Isugar239/fenec-monrepo/ailogs/HARDWARE_CAN_SILKSCREEN_SWAP.md

# Постоянная заметка: шелкография CAN перепутана на этой плате

**Дата фиксации:** 2026-08-21  
**Робот:** pupper (Pupper V3)

На control board **надписи CAN1/CAN2 на шелкографии инвертированы** относительно прошивки STM и ROS/`spine_spi_test.py`.

| Шелк на PCB | В софте / прошивке | SPI leg | Ноги (передние) |
|---|---|---|---|
| CAN2 | CAN1 (`can_ch=1`) | leg0 | front left |
| CAN1 | CAN2 (`can_ch=2`) | leg1 | front right |

При отладке всегда уточнять: **шелк или софт?**

См. полный лог теста: [2026-08-21_can1_ok_can2_dead_motor_swap.md](2026-08-21_can1_ok_can2_dead_motor_swap.md)

Отдельно (2026-09-16): CAN **id моторов 1/2/3** тоже не совпадают с abad/hip/knee на железе; примеры `spine_spi_test.py` из терминала при этом едут — [2026-09-16_motor_ids_swapped.md](2026-09-16_motor_ids_swapped.md).
