Isugar239/fenec-monrepo/ОТЧЕТ.md

# Pupper v3: от исходной политики к своей системе управления

Этот документ описывает рабочую конфигурацию робота на ноябрь 2026 года. Это не рекламное описание и не инструкция «нажать одну кнопку»: робот объединяет нейросеть, ROS 2, Raspberry Pi, две STM32-платы, SPI и четыре CAN-шины. Ошибка на любом уровне может проявиться как неправильное направление сустава, отсутствие обратной связи или падение.

## Коротко

- Робот — 12-суставный квадрупед Pupper v3: по три привода на каждую ногу.
- Raspberry Pi 5 запускает ROS 2 Jazzy и вычисляет команду для политики.
- Две STM32F446 принимают пакеты по SPI и передают команды шести моторам каждая по CAN.
- В начале использовалась готовая политика и исходная модель Pupper. Затем среда и экспорт были переработаны, а текущая политика обучена отдельно владельцем проекта.
- На обе платы установлена прошивка `SPIneV1_ros_diagnostics.elf`: она сохраняет прежний размер SPI-кадра и передаёт статусы SPI/CAN в ROS.

## 1. Откуда начался проект

Первой основой был открытый стек Pupper: описание робота, MuJoCo/MJX-среда и ROS-контроллер. В истории репозитория до сих пор есть исходные политики из проекта `pupperv3-mjx-rl`; их нельзя путать с текущими весами.

Рабочая схема исходной системы осталась полезной:

1. среда симулирует корпус, суставы и контакты;
2. PPO обучает политику выдавать добавки к позе суставов;
3. экспорт сохраняет сеть, нормализацию наблюдений и параметры управления в JSON;
4. `neural_controller` выполняет JSON в цикле `ros2_control`;
5. аппаратный интерфейс переводит команды в SPI-кадры для STM.

Ссылки на первоисточники:

- [Pupper MJX](https://github.com/Nate711/pupperv3-mjx);
- [описание Pupper v3](https://github.com/g-levine/pupper_v3_description);
- [MuJoCo и MJX](https://mujoco.readthedocs.io/en/stable/mjx.html);
- [Brax](https://github.com/google/brax).

## 2. Своя модель и обучение

Исходная среда находилась в отдельном репозитории `pupperv3_mjx`; её исходники и папки прогонов не хранятся в этом монорепозитории. Поэтому здесь остаются экспорт политики, конфигурация робота и подробное описание того, как была переделана среда.

Основные изменения своей версии:

- для корпуса использованы параметры CAD, а центр масс переведён в оси `base_link`;
- сеть видит четыре кадра наблюдений, а не длинную историю исходной политики;
- один кадр содержит 36 чисел: гироскоп, гравитацию в осях корпуса, команду скорости, желаемую вертикаль, 12 позиций суставов и 12 предыдущих действий;
- вход сети имеет размер `4 × 36 = 144`;
- сеть имеет слои `256 → 128 → 128 → 128 → 12` с ELU и `tanh` на выходе;
- действие масштабируется на `0.75` рад относительно позы покоя;
- обучение использует PPO, шаг управления 20 мс и физические подшаги MuJoCo.

Текущий экспорт находится в [`policy.json`](policy.json) и в копии, загружаемой контроллером: [`ros2_ws/src/neural_controller/launch/policy_latest.json`](ros2_ws/src/neural_controller/launch/policy_latest.json). Это один и тот же файл. Его нельзя заменять старым JSON с входом 66 или 720: контроллер ожидает именно 144 значения.

Параметры, с которыми политика обучалась по командам скорости:

| Команда | Диапазон обучения |
| --- | --- |
| вперёд/назад `vx` | −0.75…0.75 м/с |
| вбок `vy` | −0.5…0.5 м/с |
| поворот `yaw` | −2…2 рад/с |

Это не паспортные максимумы робота. За пределами этих значений политика не была проверена обучением. Режим Sport на пульте намеренно превышает их и нужен только для осторожных стендовых испытаний.

Подробности постановки задачи, CAD-параметров, наград и экспорта приведены в истории этого файла. Если воспроизводимость обучения нужна третьему человеку, исходную репозиторию с `train_pupper.py`, чекпоинтами и `runs/` следует хранить вместе с этим проектом или указать её commit hash.

## 3. Что происходит на реальном роботе

Боевой запуск идёт через `robot.service`:

```text
robot.service
  └─ robot/utils/robot.sh
      └─ ros2 launch neural_controller launch.py partial_motors:=all
```

`launch.py` поднимает `ros2_control_node`, описание робота, контроллер политики, джойстик, mux команд скорости, IMU, камеру, запись bag и вспомогательные ноды. Спавнеры контроллеров запускаются только после штатного homing: в Jazzy `controller_manager` иначе может не ответить до завершения длинного поиска нулей.

Путь команды движения:

```text
DualSense / web-пульт / person follower
        ↓
      cmd_vel_mux
        ↓
  neural_controller (RTNeural)
        ↓
control_board_hardware_interface
        ↓ SPI, 6 МГц
  две STM32F446
        ↓ CAN1…CAN4
       12 приводов
```

Политика не управляет током напрямую. Она формирует целевые положения, скорости, `kp`, `kd` и feed-forward момент. Аппаратный интерфейс ограничивает команды параметрами суставов и отправляет их в контроллеры моторов.

`gain_multiplier: 2.0` в активной ROS-конфигурации удваивает `kp` и `kd` из JSON. При параметрах экспорта `kp=5`, `kd=0.25` на мотор уходит примерно `kp=10`, `kd=0.5`. Это важно при сравнении симуляции и реального поведения.

## 4. SPI, CAN и две STM

Каждая STM обслуживает две ноги. Pi отправляет по каждому CS фиксированный SPI-кадр; STM раскладывает его на три CAN-команды для каждой ноги и возвращает положения, скорости, оценки тока и флаги.

Низкоуровневые слоты протокола называются `abad`, `hip`, `knee` и соответствуют CAN ID 1, 2, 3. Это имена слотов протокола, а не доказательство физического названия сустава. Реальное соответствие суставов и CAN хранится в [`robot/config/motor_map.yaml`](robot/config/motor_map.yaml).

Карта исправляет известное скрещивание проводов первых задних моторов. Не менять знаки или CAN-карту «на глаз»: сначала нужно сделать безопасный одиночный тест с вывешенной ногой.

## 5. Диагностическая прошивка

На обеих платах установлена [`drive_spinev1/SPIneV1_ros_diagnostics.elf`](drive_spinev1/SPIneV1_ros_diagnostics.elf).

Прошивка не меняет размер SPI-пакета. Она использует существующее поле `flags[2]` для статуса:

| Бит | Значение |
| --- | --- |
| 31 | новая диагностическая прошивка отвечает |
| 0…2 | свежий ответ CAN ID 1/2/3 |
| 3 | недавняя ошибка передачи CAN |
| 4 | недавно принят корректный SPI-кадр |
| 5 | ошибка контрольной суммы SPI |
| 6 | таймаут SPI |
| 7 | включён motor mode |

ROS публикует эти данные в `/motor_bus_diagnostics` как `diagnostic_msgs/DiagnosticArray`. Проверка:

```bash
source ~/pupperv3-monorepo/ros2_ws/install/local_setup.bash
ros2 topic echo /motor_bus_diagnostics
```

Светодиод PC5 на STM показывает активную моторную команду. Свет пульта DualSense — отдельная индикация на Pi: при падении он мигает красным и пульт непрерывно вибрирует; в нормальном состоянии синий свет меняет яркость по оценке усилия. Это не измеренный ток мотора: фактический ток не передаётся из драйвера в текущем SPI-формате.

## 6. Тесты без ROS

[`tools/spine_spi_test.py`](tools/spine_spi_test.py) повторяет бинарный SPI-протокол и подходит для диагностики платы и CAN-слота. Он может включать момент, поэтому перед запуском нужно остановить основную систему:

```bash
sudo systemctl stop robot.service
cd ~/pupperv3-monorepo/tools
sudo python3 spine_spi_test.py probe
```

Полезные команды:

- `diagnostics` — статус SPI/CAN новой STM-прошивки;
- `probe` — один валидный обмен;
- `motor-probe --can N --motor abad|hip|knee` — небольшой ход одного слота;
- `motor-scan` — последовательная проверка CAN1/CAN2;
- `homing-full` — стендовая копия штатного homing, только при понятной карте моторов.

Перед любым тестом нога должна висеть свободно. После теста скрипт отправляет `flags=0` и отпускает моторы. Если процесс прерван до этого, сначала снимите питание моторов или выполните безопасное отключение момента.

## 7. Пульт и режимы скорости

Пульт обслуживается `joy_linux_node`, а dashboard отправляет feedback в `/joy/set_feedback`. Force-feedback идёт в `/dev/input/event7`, а lightbar — через драйвер `hid-playstation`.

L1 переключает три профиля:

| Режим | `vx / vy / yaw` | Индикация |
| --- | --- | --- |
| Eco | `0.75 / 0.5 / 2.0` | зелёная вспышка |
| Comfort | `1.5 / 1.0 / 3.0` | синяя вспышка |
| Sport | `3.0 / 2.0 / 6.0` | фиолетовая вспышка |

После вспышки цвет возвращается к индикации усилия. Падение имеет приоритет над режимом: красное мигание нельзя спутать со Sport.

## 8. Ограничения и следующий безопасный шаг

1. В логах ROS усилие сустава сейчас оценивается из команды PD и ошибки положения. Это полезно как индикатор, но не заменяет реальный ток.
2. Скорости Comfort и Sport выходят за диапазон обучения. Они не должны быть режимом первого запуска после ремонта.
3. Прошивка STM собрана локальным GCC 12, тогда как старый ELF собирался GCC 14. ABI и карта памяти совпадают, но проверку на стенде нельзя заменить сравнением файлов.
4. Любое изменение CAN-карты, знака оси или позиции home проверяется сначала на подвешенной ноге с малой амплитудой.

## 9. Источники

- [ROS 2 Jazzy](https://docs.ros.org/en/jazzy/) — launch, параметры и граф ROS.
- [ros2_control](https://control.ros.org/jazzy/doc/ros2_control/index.html) — hardware interface и цикл `controller_manager`.
- [STM32F446 reference manual RM0390](https://www.st.com/resource/en/reference_manual/rm0390-stm32f446xx-advanced-armbased-32bit-mcus-stmicroelectronics.pdf) — SPI, CAN и периферия микроконтроллера.
- [STM32 HAL UM1725](https://www.st.com/resource/en/user_manual/um1725-description-of-stm32f4-hal-and-low-layer-drivers-stmicroelectronics.pdf) — используемый HAL.
- [MuJoCo](https://mujoco.readthedocs.io/en/stable/) и [Brax PPO](https://arxiv.org/abs/2106.13281) — физическая среда и обучение политики.
