Isugar239/fenec-monrepo/ailogs/2026-06-26_stm_original_bno_off.md

# Лог отладки: исходная прошивка STM, отключение BNO

Дата: 2026-06-26

Продолжение: [2026-06-25_spi_loopback.md](2026-06-25_spi_loopback.md)

## Контекст
- На **обеих** STM стоит **оригинальная прошивка** (`SPIneV1` / штатная control board).
- **Перепрошить на loopback/echo нельзя** (у левой платы сломан прошивочный разъём — см. лог 2026-06-24; отладка только со штатной прошивкой + осциллограф / `spine_spi_test`).
- Ранее loopback **только на Pi** (MOSI↔MISO на малине) подтвердил, что SPI контроллер Pi исправен — см. [2026-06-25_spi_loopback.md](2026-06-25_spi_loopback.md).
- `robot.service` забивался спамом BNO055 — IMU не работает (`use_imu=false`).

## Что сделали

### 1. Убрали BNO из логов robot.service
**Источник спама:** не отдельная ROS-нода, а драйвер `BNO055` в `control_board_hardware_interface`:
- `ros2_ws/src/control_board_hardware_interface/src/rt/rt_bno055.cpp` — `printf` при ошибках I2C read
- `ros2_ws/src/control_board_hardware_interface/src/imu_manager.cpp` — фоновый поток `imu_read_thread_fn` постоянно вызывает `imu_->sample()` → `receivePacket()`

Поток крутится внутри `ros2_control_node` (плагин `ControlBoardHardwareInterface`).

**Исправление:** включён `<param name="use_imu">false</param>` в
`ros2_ws/src/pupper_v3_description/description/pupper_v3.ros2_control.xacro`.

Это не создаёт `BNO055`, не стартует IMU-поток. В логах один раз: `IMU not enabled`.
Проверено: после рестарта `robot.service` — **0 строк BNO055**.

### 2. SPI с исходной прошивкой STM (robot.service остановлен)

`spi_watch` (6 МГц, spine-пакет 132 байта):

| CE | Устройство | Наблюдение |
|----|---|---|
| CE0 | `/dev/spidev0.0` | `rv=132`, не нули; `rep_chk` прыгает (`0xffffffff`, `0x00000000`, `0x00030000`…); floats часто 0.0 |
| CE1 | `/dev/spidev0.1` | `rv=132`, `rep_chk=0xffffffff` стабильно; floats = **-nan** (MISO = 0xFF) |

`spi_loopback.py` (16 байт `0xA0..0xAF`): на обоих CE «OK», но после `xfer2` буфер перезаписан RX — видим `0x00, 0x00, 0x3f, 0xff…`, не паттерн 0xA0. Это ответ STM/шины, не чистый loopback на Pi.

В `robot.service` (до остановки): лавина `SPI ERROR BAD CHECKSUM GOT … EXPECTED 0xffffffff` — STM отвечает, но чексумма spine не сходится.

## Вывод
| Компонент | Статус |
|---|---|
| BNO055 / логи | **отключены** (`use_imu=false`) |
| SPI ioctl Pi | OK (`rv=132`) |
| CE0 + STM | есть ответ, не валидный spine |
| CE1 + STM | MISO ≈ 0xFF (-nan), slave не отдаёт данные |
| Joint states | по-прежнему не проверялись в этой сессии |

Гипотеза: обе STM на штатной прошивке, но **MISO не драйвится** (0xFF / холмики на осциллографе) — slave SPI не отвечает: NSS/CE, питание, BOOT0, обрыв MISO, или прошивка не входит в SPI handler.

## Следующие шаги
1. Осциллограф: CE0 vs CE1 — кто реально дёргается при обмене с нужной STM.
2. Проверить питание и BOOT0 обеих STM, power-cycle.
3. Сравнить `spi_watch` с документацией spine: порядок байт, размер пакета, ожидаемый `rep_chk`.
4. Когда BNO починят — вернуть `use_imu` в xacro.

## Файлы
- `tools/spine_spi_test.py` (новый)
- `ailogs/2026-06-26_stm_original_bno_off.md` (этот лог)

## 2026-06-26 (продолжение): spine_spi_test.py

Добавлен `tools/spine_spi_test.py` — Python-тест протокола spine без ROS.

Команды:
```bash
sudo systemctl stop robot.service
python3 tools/spine_spi_test.py selftest   # кодирование без железа
sudo python3 tools/spine_spi_test.py probe # разовый обмен CE0+CE1
sudo python3 tools/spine_spi_test.py watch
sudo python3 tools/spine_spi_test.py enable
sudo python3 tools/spine_spi_test.py read
sudo python3 tools/spine_spi_test.py homing --seconds 3
```

Протокол (из `rt_spi.cpp` / `rt_spi.h`):
- `spine_cmd_t`: 33×u32, XOR checksum по 32 словам, `flags[0/1]=1` включает моторы
- `spine_data_t`: 15×u32, XOR по 14 словам
- byte-swap каждого u16 на проводе, 132 байта, 6 МГц MODE0
- CE0 → ноги 0–1, CE1 → ноги 2–3

Текущий результат `probe`: обе платы `miso_0xFF` — STM не драйвит MISO (подтяжка). Homing не запускается без OK checksum.

## 2026-06-26: spi_loopback.py — ложный OK

**Баг в `spi_loopback.py`:** `spidev.xfer2` перезаписывает TX-буфер ответом. Скрипт печатал TX после xfer → оба показывали `0xFF` и «OK», хотя реально слали `0xA0..0xAF`. Исправлено: сохраняем `tx_sent` до xfer.

Правильный тест (обе STM на **оригинальной** прошивке, не echo):
```bash
sudo python3 tools/spi_loopback.py 0 0
sudo python3 tools/spi_loopback.py 0 1
```

| CE | Результат (после фикса скрипта) |
|----|---|
| CE0 | TX `0xa0..0xaf`, RX `0xFF` — spine slave не эхоит байты |
| CE1 | то же |

Ранний «OK» на CE0 — **артефакт бага**, не доказательство echo-прошивки. Echo/loopback на STM **не ставили** (перепрошить нельзя).

## 2026-06-26: осциллограф на MISO

**Наблюдение пользователя на MISO (Pi pin21 / STM PA6):**
- Нет нормальных прямоугольников 0↔3.3 В
- Только **2 небольших «холмика»**, явно **не дотягивают до 3.3 В**
- Не на всю ширину бита — активность видна **после середины** импульса SCK (или второй половины кадра)

**Интерпретация:**
| Что видим | Что это значит |
|---|---|
| MISO ≈ 3.3 В постоянно, Pi читает 0xFF | Линия **в high-Z**, тянет **подтяжка** (внутренняя Pi или внешняя), slave **не драйвит** |
| 2 маленьких холмика без полного уровня | **Не валидные биты данных** — скорее наводка от SCK/MOSI на «болтающийся» MISO, либо STM **мгновенно** пытается выставить MISO и отпускает (неправильный режим пина / slave не в SPI / NSS не совпадает) |
| Холмики «после половины» бита | Типично для **ёмкостной наводки** на floating-линии, синхронной с фронтом SCK — не для push-pull slave |

**Вывод:** аппаратно Pi→STM по SCK/MOSI/CE, вероятно, жив; **обратный канал MISO не работает как выход slave**. Это согласуется с RX=0xFF в софте.

**Что снять дальше (триггер на падение CE):**
1. **Одновременно 4 канала:** CE (pin24 или 26), SCK, MOSI, MISO — одна и та же STM (PA4–PA7)
2. **MISO на двух точках:** у PA6 на STM и у pin21 на Pi — обрыв между платами?
3. **CE0 vs CE1** при `spi_loopback.py` — какой CE доходит до какой STM (обе на orig прошивке)
4. **Замедлить SPI** до 100 кГц — если холмики те же, не timing 6 МГц
5. **BOOT0, power-cycle**, питание 3.3 V на STM — без UART echo-прошивки (перепрошить нельзя)

**Гипотезы по убыванию вероятности:**
1. STM не в режиме SPI slave (прошивка / BOOT0 / reset) — MISO не переключён в AF push-pull
2. Обрыв или плохой контакт MISO (PA6 ↔ pin21) — на STM холмики есть, на Pi нет (или наоборот)
3. NSS (PA4) не совпадает с CE — slave не выбирается, MISO остаётся в Z (холмики = наводка)
4. Повреждение вывода PA6 / линии MISO

## 2026-06-26: осциллограф CE0 + MOSI (фото)

**Снято:** CH2 зелёный = **CE0** (pin24), CH1 жёлтый = **MOSI** (pin19). Масштаб ~1 V/div.

**Что видно:**
- **CE0** — нормальный active-low: в покое ~3.3 V, на время транзакции уходит в 0 V, потом снова high.
- **MOSI** — во время (и рядом с) активным CE идут **пакеты данных** (плотная рябь 0↔high). Pi **шлёт**.
- На том же захвате: первый кусок MOSI может начинаться **чуть раньше** падения CE — стоит перепроверить **4 канала с триггером на ↓CE** (артефакт развёртки или два подряд `ioctl`).

**MISO + CE0 (отдельный замер пользователя):**
- CE0 скачки **есть** (как на фото)
- **MISO молчит** — ровная линия, slave **не выдаёт** данные

| Линия | Статус |
|---|---|
| CE0 (Pi → NSS) | ✅ Pi выбирает устройство |
| MOSI | ✅ Pi шлёт байты |
| MISO | ❌ нет ответа slave |
| SCK | не снят на этом кадре — снять следующим |

**Жёсткий вывод:** проблема **не в «Pi не шлёт»**. Цепочка **Pi → CE/MOSI/(SCK)** живая; **обратный канал MISO / STM slave** — нет. Софт `RX=0xFF` подтверждён железом.

**Следующий критичный замер:** триггер на ↓CE0, 4 канала — **CE0, SCK, MOSI, MISO** на **PA4–PA7** той STM, к которой идёт CE0:
- Падает ли **PA4 (NSS)** вместе с CE0? Если CE0 на Pi есть, а PA4 нет → обрыв CE или не та плата
- **PA6 (MISO)** — тоже молчит или есть холмики? Сравнить с pin21 Pi

## 2026-06-27: отключена вторая STM (непрошиваемая)

Пользователь **физически отключил** вторую control board (левая, без рабочего прошивочного разъёма). На шине осталась одна STM с orig-прошивкой.

**Субъективно:** «ничего не изменилось или хуже».

**Софт после отключения** (`robot.service` stop):

| Тест | Было (2 платы) | Стало (1 плата) |
|---|---|---|
| `spi_loopback` CE0 RX | `0xFF` | **`0x00`** (все нули) |
| `spi_loopback` CE1 RX | `0xFF` | **`0x00`** |
| `spine_spi_test probe` | `miso_0xFF` / -nan | **`all_zero`**, flags=0 |

**Вывод:** поведение **изменилось** — MISO перестал читаться как 0xFF, теперь **все нули**. Валидного spine-ответа по-прежнему **нет**.

**Интерпретация:**
1. **MISO, вероятно, общая** на обе платы до Pi — вторая STM тянула линию в **high** (0xFF), пока была подключена; без неё линия уходит в **0** (подтяжка вниз / только первая плата / обрыв).
2. Отключение второй платы **не починило** связь — оставшаяся STM **всё ещё не отвечает** валидными данными.
3. «Хуже» в софте: нули вместо 0xFF — joint_states остаются мёртвыми; checksum spine не сходится.

**Следующий шаг:** осциллограф на **оставшейся** плате — PA4 (NSS) при CE0, PA6 (MISO). Если NSS не падает → CE0 не доходит до этой STM. Если NSS ок, MISO молчит → прошивка/BOOT0/PA6.

## 2026-06-27: разбор `stm32_spi_slave.ino`

Просмотр тестовой прошивки (когда-то прошивали правую STM — без эффекта на MISO).

### Критический баг: PA4 (NSS) не в alternate function

Комментарий говорит «hardware NSS», но в коде:
- PA5–PA7 → **AF5** ✅
- PA4 → только `PUPDR` сброшен, **MODER остаётся GPIO input**, **AFR для PA4 не AF5** ❌

При `SSM=0` (hardware NSS) периферия SPI1 смотрит на **PA4 как SPI1_NSS**, а не на произвольный GPIO. CE с Pi на PA4 **не попадает в SPI** → slave не участвует в обмене → **MISO молчит**. Это **точно объясняет** тест с этой прошивкой.

**Исправлено в репо:** PA4 → AF5, OSPEED high; убран вечный `while (!Serial)`.

### Другие замечания

| Тема | Деталь |
|---|---|
| Не echo | `tx_buf[i]=0xA5^i` — на MISO паттерн `0xAA, 0xA5, 0xA4…`, **не** повтор MOSI. `spi_loopback` (0xA0..0xAF) **не подходит** для проверки — нужен `spi_watch` / смотреть UART `spi_count` |
| UART | `spi_count` delta > 0 при обмене с Pi = STM **видит** SPI |
| 6 МГц | ISR на байт может не успевать; для первого теста Pi на 1 МГц |
| Orig SPIneV1 | Должна конфигурировать NSS правильно (иначе не работало бы у других). Если orig тоже молчит — **железо** (PA4 не доходит от CE0, обрыв MISO) |

### Связь с осциллографом

CE0 на Pi есть, MOSI есть, MISO молчит — согласуется с **NSS не доходит до SPI** (баг прошивки **или** обрыв CE до PA4 на плате).

**Решающий замер:** PA4 на STM при ↓CE0 — если не падает, проблема **до** STM (разъём/CE mapping).

---

## Обновление: echo-прошивка для одной прошивки (2026-06-26)

UART недоступен, прошить STM можно **один раз**. Подготовлена минимальная echo-прошивка и обновлён тест.

**Подробный лог:** [2026-06-26_spi_echo_firmware.md](2026-06-26_spi_echo_firmware.md)

### Что изменено
- `tools/stm32duino_spi_slave/stm32_spi_slave.ino` — byte echo MOSI→MISO, PA4=AF5 (NSS), **без UART**
- `tools/spi_loopback.py` — 17 байт, распознаёт STM echo (`RX[0]==TX[0]`, `RX[1:]==TX[:-1]`)

### Прошивка → проверка
```bash
# Arduino/STM32Duino: upload stm32_spi_slave.ino на доступную STM
sudo systemctl stop robot.service
sudo python3 tools/spi_loopback.py 0 0 1000000   # CE0
sudo python3 tools/spi_loopback.py 0 1 1000000   # CE1
```

**Успех:** `OK — STM32 SPI echo: MOSI→MISO (pipeline 1 байт)`

### Результаты прогона (конец сессии 2026-06-26)

`robot.service` остановлен. Команды:
```bash
sudo python3 /home/pi/pupperv3-monorepo/tools/spi_loopback.py 0 0 1000000
sudo python3 /home/pi/pupperv3-monorepo/tools/spi_loopback.py 0 1 1000000
```

| CE | Устройство | TX | RX | Результат |
|----|---|----|----|---|
| CE0 | `/dev/spidev0.0` | `0xA0..0xB0` (17 байт) | все `0x00` | **FAIL** — slave молчит |
| CE1 | `/dev/spidev0.1` | `0xA0..0xB0` (17 байт) | все `0x00` | **FAIL** — slave молчит |

Вывод терминала (оба CE идентичны):
```
FAIL — 17/17 байт не совпали (ни wire, ни slave echo)
  (все нули — MISO не подключён / slave молчит)
```

**Вывод сессии:** на обоих CE MISO не отдаёт данные (нули, не echo). Echo-прошивка в репо готова, но **на плату ещё не залита** (или залита не та плата / не тот CE). Следующий шаг — одна прошивка `stm32_spi_slave.ino` на доступную STM, повторить тест на соответствующем CE.

**Пауза до следующей сессии.**
