Isugar239/fenec-monrepo/ailogs/2026-08-22_before_txrx_continuity_check_poweroff.md

# Лог: перед power-off — прозвон TX/RX CAN2 (STM ↔ MAX3051)

Дата: **2026-08-22**, ~20:30 UTC+3  
Предыдущие: [2026-08-22_after_r2_solder_still_dead.md](2026-08-22_after_r2_solder_still_dead.md), [2026-08-22_before_r2_solder_poweroff.md](2026-08-22_before_r2_solder_poweroff.md)

---

## Итоговая картина (зафиксировано пользователем)

| | CAN1 / leg0 (шелk CAN2, левая) | CAN2 / leg1 (шелk CAN1, правая) |
|---|---|---|
| **fb в софте** | ✅ меняется | ❌ всегда 0 |
| **Нога двигается** | ✅ да | ❌ нет |
| **Красный LED на моторах** | горит постоянно | горит постоянно (только питание!) |
| **Swap DAP** | — | мёртвость не переехала |
| **R2 120 Ω** | — | запаян — не помог |
| **Напряжения DD4** | — | OK (пользователь проверила) |

**Вывод:** CAN2 мёртв **целиком** (не только RX). Команды с STM, похоже, **не доходят** до шины → подозрение на **TX/RX между STM и MAX3051 (DD4)** или мёртвый DD4.

⚠️ Шелк CAN1/CAN2 на spine **перепутан** — см. [HARDWARE_CAN_SILKSCREEN_SWAP.md](HARDWARE_CAN_SILKSCREEN_SWAP.md).

---

## Последний probe (2026-08-22 вечер)

```
[/dev/spidev0.0] CE0 board0 legs[0,1]: checksum_OK
    leg0: abad= 0.1223 hip= 0.2565 knee= 0.1211  ✅
    leg1: abad= 0.0000 hip= 0.0000 knee= 0.0000  ❌
```

## Последний wiggle с feedback

**CAN1 (левая):**
- abad: fb застрял ~0.122 (робот лежит — abad мог упираться)
- hip: span=0.633 OK
- knee: span=0.249 OK

**CAN2 (правая):**
- abad/hip/knee: cmd меняется, **fb=0.000**, span=0.000

---

## Что проверить ПОСЛЕ power-off (мультиметр, прозвонка)

**Питание полностью выключено.** Режим **Ω / diode / continuity** (писк).

### Spine STM (прошивка `drive_spinev1`)

| Сигнал | Pin STM | Pin MAX3051 (DD4) | Живой канал для сравнения |
|---|---|---|---|
| CAN2 TX | **PB13** | pin **1** (TX) | PB9 → DD2 pin 1 |
| CAN2 RX | **PB12** | pin **4** (RX) | PB8 → DD2 pin 4 |

### E3.pdf (если CAN2 идёт через distribution-плату, DD4)

| Сигнал | Pin STM (DD1) | Pin MAX3051 (DD4) |
|---|---|---|
| CAN2 TX | **PA12** | pin **1** |
| CAN2 RX | **PA11** | pin **4** |

**Ожидание:** **~0 Ω** (короткий писк) на каждой паре.

| Результат | Значит |
|---|---|
| **Пищит** на TX и RX | Дорожки целые → подозреваем **сам DD4** или CANH/L после чипа |
| **∞ на TX (PB13→DD4-1)** | **Обрыв TX** — главный подозреваемый |
| **∞ на RX** | Обрыв RX |
| **∞ на обоих** | Обрыв/не та плата/не те pin'ы |

### Дополнительно (опционально)

| Замер | Ожидание |
|---|---|
| DD4 pin 3 (VCC) ↔ GND | **не 0 Ω** (не КЗ) |
| CANH (pin 7) ↔ CANL (pin 6) через R2 | **~120 Ω** |
| CANH/L на разъёме ↔ pin 7/6 DD4 | **~0 Ω** каждая |

---

## Команды после включения

```bash
cd ~/pupperv3-monorepo/tools
sudo systemctl stop robot.service
sudo python3 spine_spi_test.py probe -v
sudo python3 spine_spi_test.py wiggle-can2-all --seconds 2 --amplitude 0.10 --hz 0.4
```

---

## Состояние системы

- `robot.service`: **inactive**
- Пользователь выключает питание для **прозвонки TX/RX**
- CE1 (`spidev0.1`) по-прежнему `all_zero` — отдельная проблема (вторая STM)
