Isugar239/fenec-monrepo/ailogs/2026-08-23_before_tx_jumper_poweroff.md

# Лог: перед power-off — jumper TX PB13 → DD4 pin 1

Дата: **2026-08-23**  
Предыдущий: [2026-08-23_after_tx_resolder_2_still_fail.md](2026-08-23_after_tx_resolder_2_still_fail.md)

---

## Текущая картина

| | CAN1 leg0 (левая) | CAN2 leg1 (правая) |
|---|---|---|
| probe | ✅ | ✅ (RX жив) |
| wiggle fb | ✅ движение | ❌ span≈0, fb застрял |
| физически | двигается | **не двигается** |
| звук | жжж + движение | **короткий жжж**, без движения |

**Вывод:** TX CAN2 работает **кусками** (enable → звук), нормальное управление нет.  
Прозвонка PB13↔DD4-pin1 **звонится**, но под нагрузкой может рваться → подозрение на **дорожку TX**.

Перепайка TX ×2 — **не помогла**. R2 120Ω — стоит. Swap DAP — не помог.

---

## Что делает пользователь сейчас

**Power OFF** → jumper (восковка/провод):

```
PB13 (STM TX CAN2) ──── провод ──── pin 1 (TX) DD4 MAX3051
```

- **Не** CANH/CANL
- **DD4**, не DD2 (CAN1)
- Короткий провод, не параллельно CAN-линиям

---

## После включения — тест

**Не двигать правую ногу руками!**

```bash
cd ~/pupperv3-monorepo/tools
sudo systemctl stop robot.service
sudo python3 spine_spi_test.py probe -v
sudo python3 spine_spi_test.py wiggle-can2-all --seconds 3 --amplitude 0.12 --hz 0.4
```

## Интерпретация

| Результат | Вывод |
|---|---|
| fb меняется, нога **сама** двигается | ✅ **дорожка TX бита** — jumper оставить |
| жжж, fb=0, нет движения (как сейчас) | jumper не помог → **менять DD4** |
| leg1=0 в probe | не туда припаяла / новая проблема |

---

## Состояние

- `robot.service`: **inactive**
- CE1 spidev0.1: `all_zero` (вторая STM, отдельно)
- SSH отвалится при power-off — нормально
