Isugar239/fenec-monrepo/ailogs/2026-08-31_homing_full_front.md

# Лог: homing-full передние ноги

Дата: **2026-08-31**  
Сырьё: `raw/2026-08-31/homing_full_board0_retry2.txt`

Задние (CE1) молчат — **не все 12**, только CAN1+CAN2.

Первый запуск оборвался: homing слал полный пакет, потом `enable_only` на чтение → SPI BAD_CHK/all_zero и ложные Homed с мусором (`1e19`).

Повтор: состояние берётся из того же командного кадра.

```
Homed knees → hips → abads, Finished 1.7s / 84 шагов
до:  L -0.514 / 0.257 / 3.847    R  0.592 / -0.022 / -3.893
после: L -0.513 / 0.619 / 3.869    R  0.564 / -0.305 / -3.937
```

Хипы реально уехали (~0.3 рад). Колени почти нет (уже ±3.85, «упор» ложный). 1.7 с — не настоящий механический homing.

**Пользователь подтвердила:** обе передние ноги **отодвинулись от тела** (хипы). Значит TX на CAN1 и CAN2 доходит до hip-моторов.

`robot.service` оставлен **inactive**.
