Isugar239/fenec-monrepo/ailogs/2026-08-31_legs_powered_wiggle.md

# Лог: питание лап включили — probe OK, wiggle без движения

Дата: **2026-08-31**  
Предыдущий сегодня: [2026-08-31_legs_spi_all_zero.md](2026-08-31_legs_spi_all_zero.md)  
23-е: [2026-08-23_before_dd4_replace_poweroff.md](2026-08-23_before_dd4_replace_poweroff.md)  
Сырьё: `ailogs/raw/2026-08-31/spi_probe_powered.txt`, `wiggle_can1_powered.txt`, `wiggle_can2_powered.txt`

---

## Probe (питание есть)

```
CE0 checksum_OK
  leg0 CAN1: abad=0.076 hip=0.250 knee=0.291  ✅
  leg1 CAN2: abad=-0.020 hip=0.076 knee=-0.309  ✅ RX жив
CE1 all_zero (вторая STM, как раньше)
```

I2C-1 по-прежнему пустой (нет `0x48`). EXT5V ~5.14 V в момент probe.

---

## Wiggle (скрипт пишет OK — это ложные span)

`fb` в логе — **сырой** угол STM, `cmd` — после `SIDE_SIGN`. Поэтому cmd ≈ −fb в покое. Реальное движение = **меняется ли fb**.

### CAN2 правая (шелк CAN1)

| Сустав | fb во время теста | Реально |
|---|---|---|
| abad | застрял −0.020 | ❌ |
| hip | застрял +0.073 (первый кадр BAD_CHK, мусорный span) | ❌ |
| knee | −0.327 … −0.302 (Δ≈0.025) | ❌ почти нет |

cmd ходит ±0.12, fb не следует. Как 23-го.

### CAN1 левая (шелк CAN2)

| Сустав | fb во время теста | Реально |
|---|---|---|
| abad | застрял +0.076 (span=0.152 = 2×\|q\|, знак) | ❌ |
| hip | застрял +0.250 | ❌ |
| knee | +0.286 … +0.298 (Δ≈0.012) | ❌ |

**23-го CAN1 физически ехал.** Сегодня не едет тоже.

После wiggle углы те же ±шум.

---

## Вывод

Логика STM/CAN **RX жива на обеих передних**. TX/момент на моторы **не доходит** (или нет силового питания моторов / ноги упёрты).

CAN2 — тот же диагноз, что 23-го (jumper TX / DD4).  
CAN1 сегодня ведёт себя так же — либо силовая шина моторов ещё не под напряжением, либо ноги зажаты.

`robot.service` снова **active**.
