Isugar239/fenec-monrepo/ailogs/2026-09-23_joints_ok_stand_bno.md

# Лог: суставы едут, стойка кривая, БНО в софте выключена

Дата: **2026-09-23** (~20:45 MSK)  
Хост: `pupper` (`pi@10.2.0.217`)  
Предыдущие: [2026-09-16_motor_ids_swapped.md](2026-09-16_motor_ids_swapped.md), [2026-06-26_stm_original_bno_off.md](2026-06-26_stm_original_bno_off.md)

## Главное

Суставы на этом запуске **завелись**. Походку включали (`neural_controller` activate). **Нормально не стоит.** Подозрение — нет рабочей связи с БНО.

В этом же старте софт сам пишет `IMU not enabled`: в `pupper_v3.ros2_control.xacro` параметр `use_imu` стоит `false`. Драйвер BNO055 не читается, в политику уходит единичный кватернион («стою ровно»), даже если корпус наклонён. Угол платы в `components.xacro` при этом не применяется.

Плата БНО переставлена вертикально, «90° вверх». В `components.xacro` pitch сменён с `-2.35619` (−135°) на `-1.57079632679` (−90°). Пока `use_imu=false`, эта правка на стойку не влияет.

Hailo для походки не нужен: нода падает без драйвера, сервис от этого не останавливается.

## Хоуминг 20:41:12

Почти все суставы `ЕХАЛ ДЕРЖИТ`. Исключения по таблице:

| Сустав | CAN | id | Δ | Статус |
|---|-----|----|---|---|
| leg_front_r_2 | 2 | 2 | −0.097 | СТОИТ ДЕРЖИТ |
| leg_back_l_2 | 3 | 2 | +0.037 | СТОИТ ДЕРЖИТ |
| leg_back_r_2 | 4 | 2 | −4.130 | ЕХАЛ ДЕРЖИТ (большой ход) |

Остальные восемь проехали и держат момент. Заднее правое колено в этом запуске тоже поехало (в 20:40 оно было `СТОИТ ОТПУЩЕН`).

## Походка

- 20:42:49 `neural_controller`: activate successful
- 20:43:41 deactivate
- 20:43:54 activate снова
- 20:45:04 deactivate

На глаз стойка не нормальная. Команда скорости не слалась: контроллер сам тянет суставы в `default_joint_pos` и дальше крутит политику.

## Что не проверено

Живой ли I2C BNO055 на проводе, в этом логе не меряли. Сначала в конфиге `use_imu=false`, поэтому «нет связи» здесь — это выключенный драйвер, не обязательно мёртвый чип.
