Isugar239/fenec-monrepo/ailogs/2026-08-31_legs_retry2_can2_knee.md

# Лог: повторный wiggle — CAN2 knee едет, CAN1 fb застыл

Дата: **2026-08-31** (вторая попытка, питание было)  
Предыдущий: [2026-08-31_legs_powered_wiggle.md](2026-08-31_legs_powered_wiggle.md)  
Сырьё: `raw/2026-08-31/wiggle_can1_retry2.txt`, `wiggle_can2_retry2.txt`

Между попытками `robot.service` крутился — углы уехали (похоже homing/unwrap):

```
до:  CAN1 0.076 / 0.250 / 0.291     CAN2 -0.020 / 0.076 / -0.309
после: CAN1 -0.506 / 0.274 / 3.854  CAN2  0.597 / -0.024 / -3.895
```

---

## CAN1 левая — fb не сдвинулся

Пользователь в **прошлом** прогоне слышала звук и дёрганье. В этом fb константа:

| Сустав | fb |
|---|-----|
| abad | −0.506 весь прогон |
| hip | +0.274 |
| knee | +3.854 |

«span OK» в скрипте = 2×\|q\| (знак cmd vs raw), не движение.

## CAN2 правая — **knee едет**

| Сустав | fb | |
|---|-----|---|
| abad | застрял +0.597 | ❌ |
| hip | застрял −0.024 | ❌ |
| knee | −3.939 … −3.767 (Δ=0.172, следует cmd) | ✅ первое реальное движение CAN2 с 23-го |

---

## Вывод

TX на CAN2 **не мёртвый**: колено правой ноги отслеживает команду. Abad/hip CAN2 и все три CAN1 в этом прогоне по энкодеру молчали (CAN1 физически дёргалась в прошлом).

Jumper TX, скорее всего, жив. DD4 целиком не «труп». Дальше: abad/hip CAN2 (другой мотор/разъём/ID) и почему CAN1 нестабилен.
