Isugar239/fenec-monrepo/ai/rl/REAL_DATA.md

# Реальные данные Pupper: как записать и как на них учиться

Инструкция для человека или ИИ, который продолжит работу. Код записи — `tools/pupper_record.py`, кнопка «Запись» в пульте (`tools/pupper_dashboard`).

## Главное решение: чему учиться на реальных данных

Политику ходьбы учим в симуляции (MJX, `pupper_mjx_rl_training.py`, 1B шагов на GPU). Реальные данные нужны, чтобы **симулятор стал похож на робота** (system identification, sysid), а не чтобы учить политику прямо на них. Причины:

- Политика плохо ходит на железе почти всегда из-за разрыва sim→real: другие kp/kd, трение и инерция ротора, задержка, масса и центр масс, нули суставов. Сотни тысяч эпизодов на реальном роботе не собрать, а 10–20 минут записи хватает, чтобы подогнать 5–15 параметров симулятора.
- Обучение прямо на роботе (онлайн RL в реальном времени, SAC/DroQ, как в работах «learning to walk in the real world») возможно: порядка десятков минут до часа хождения с ручными подъёмами после падений. Нужны ПК с GPU рядом, сеть с малой задержкой, автоматический подъём или человек и крепкая механика. Этот путь стоит пробовать только после того, как sim→real с подогнанным симулятором не помог.
- Behavior cloning с генератора траекторий бессмыслен: генератор и так известен как формула (`tools/open_loop_gait.py`).

Порядок работы: **(1) sysid приводов на подставке → (2) sysid корпуса на полу → (3) переобучение с новыми параметрами и сужением рандомизации → (4) проверка политики на роботе с записью → сравнение наблюдений sim и real.**

## Что пишется

`python3 tools/pupper_record.py record --note "..."` или кнопка в пульте создаёт каталог `~/pupper_data/<время>_<метка>/`:

- `bag/` — `ros2 bag` в формате mcap, без прореживания:
  - `/joint_states` около 256 Гц: позиция, скорость, effort (оценка момента с драйвера, Н·м);
  - `/imu_sensor_broadcaster/imu` около 256 Гц;
  - `/forward_position_controller|kp|kd/commands` — команды генератора, стойки и пульта (12 чисел, порядок как в `JOINTS`);
  - `/neural_controller/position_command` и `/neural_controller/observation` — команды и наблюдения политики;
  - `/cmd_vel`, `/emergency_stop`, `/robot_description` (URDF с нулями хоуминга на момент записи).
- `meta.json` — заметка, git-коммит и список изменённых файлов, `motor_map.yaml`, параметры режима от пульта (`extra`: параметры генератора `tg_params`, режим).

Объём — около 100 КБ/с, то есть примерно 360 МБ в час. Запись стартует примерно через 2 секунды после команды.

`python3 tools/pupper_record.py export <сессия>` → `dataset.npz`:

| ключ | форма | смысл |
|---|---|---|
| `js_t, js_q, js_dq, js_tau` | (N), (N,12) | сырые суставы, время от начала, с |
| `imu_t, imu_quat_xyzw, imu_gyro, imu_acc` | (M), (M,4/3) | сырое IMU |
| `fwd_*, kp*, kd*, nn_*, obs*, cmdvel*, estop_t` | | сырые команды |
| `t` | (T) | сетка 50 Гц (= `environment_dt` 0.02) |
| `q, dq, tau, quat_xyzw, gyro` | (T,12/4/3) | последнее значение не позже `t` |
| `cmd_q` | (T,12) | активная команда позиции: самая свежая из forward и политики |
| `cmd_src` | (T) | 0 — forward (генератор или стойка), 1 — политика, −1 — нет команды |
| `kp_cmd, kd_cmd` | (T,12) | коэффициенты forward-контроллеров; NaN, если их не слали |
| `cmd_vel` | (T,3) | vx, vy, wz |
| `valid` | (T) | IMU свежее 50 мс, команда свежее 100 мс, до первого e-stop |
| `urdf, meta, joints` | | строки |

Подводные камни:

- Когда работает политика, её kp/kd в топики **не публикуются**: они берутся из `ros2_ws/src/neural_controller/launch/config.yaml` (`init_kps` 7.5, `init_kds` 0.25, `gain_multiplier`) и из json политики. Учитывай их отдельно.
- Порядок суставов: `leg_front_r_1..3, leg_front_l_1..3, leg_back_r_1..3, leg_back_l_1..3`. По URDF `_1` — бедро (вперёд-назад), `_2` — отведение (вбок), `_3` — колено. В старых комментариях `_1` ошибочно назван abad.
- Нули суставов (`homed_position` в `components.xacro`) меняются через пульт. Сверяй URDF из `dataset.npz` с URDF, по которому учишь. Смешивать записи с разными нулями без поправки нельзя.
- Для 250 Гц используй сырые `js_*`: эффекты привода (задержка, трение) видны только на полной частоте.
- Закон управления в драйвере мотора: `τ = kp·(q_cmd − q) + kd·(0 − dq)`, с ограничением `effort_max` 3 Н·м и `kp_max`/`kd_max` из `components.xacro`. В MuJoCo этому соответствуют `position_control_kp` и `dof_damping` (в `conf/training/default.yaml` сейчас 5.0 и 0.25). Проверь это по прошивке и `control_board_hardware_interface.cpp`, прежде чем подгонять.

## Протокол записи и сколько нужно данных

Одна сессия — один режим и одно покрытие. Пиши в `--note` всё, что меняет физику: подставка или пол, покрытие, батарея, груз, kp/kd.

**A. Приводы на подставке (лапы в воздухе) — самое ценное. Нужно 10–15 минут.**
Генератор, `stride` 0–0.05 м, `lift` 0.01–0.05 м, `freq` от 0.5 до 3 Гц с шагом 0.5, kp 6/10/15, kd 0.2/0.4/0.8. Каждая комбинация — 20–30 секунд, отдельная сессия или одна длинная с заметками. Это даёт отклик привода на разных частотах без контакта с землёй. Лучше добавить отдельный скрипт возбуждения (chirp 0.2–10 Гц и ступеньки ±0.2 рад по одному суставу при kp 5/7.5/10). Его пока нет — это следующий шаг.
Из этих данных подгоняются: эффективный kp и kd, `armature` (инерция ротора), трение (`frictionloss`), `dof_damping`, задержка (в тактах 2–4 мс), насыщение момента. Около 12 суставов × 5 параметров; 10 минут при 250 Гц — это около 150 тысяч точек на сустав, с большим запасом.

**B. Корпус на полу. Нужно 10–20 минут.**
Стойка по 30 секунд (статика: масса, центр масс по моментам бедра и колена), генератор на месте и с шагом 1–4 см, повороты, политика с `cmd_vel` 0 / 0.2 / 0.4 / 0.75 м/с. Минимум 1–2 минуты на каждый режим. Отсюда подгоняются масса и центр масс корпуса, трение лапы о пол, согласуется IMU (знаки, смещение гироскопа и наклон установки).

**C. Проверка после переобучения. Нужно 2–5 минут на политику.**
Та же программа `cmd_vel`, что в симуляции. Сравни распределения `obs` (угловая скорость, вектор гравитации, позиции суставов, прошлое действие) real и sim при одинаковых командах. Сдвиг средних или дисперсий укажет, что ещё не совпадает.

Итого для первого цикла sysid хватает **30–40 минут** записи. Больше данных полезно только для новых условий (покрытия, груз). Однообразные длинные записи почти ничего не добавляют.

## Как подгонять (sysid)

1. `uv sync` в `ai/rl`. Модель MuJoCo — из `simulation.model_repo` (`conf/simulation/default.yaml`). Скачай ту же, что использует обучение.
2. Подставка: закрепи корпус (base без freejoint или weld) и отключи контакты лап. Прогони в MuJoCo сырые `cmd_q`, `kp_cmd`, `kd_cmd` с шагом физики 0.002–0.004 с и сравни `q_sim` и `q_real`. Функция потерь — MSE позиции плюс взвешенная MSE скорости по окнам 2–5 секунд, с начальным состоянием из реальных данных. Оптимизатор — CMA-ES (`cma`) или `scipy.optimize.least_squares` по параметрам: `kp_scale`, `kd_scale`, `armature`, `frictionloss`, `damping`, `delay_steps`. Отдельно для бедра, отведения и колена или общие — сначала общие.
3. Валидация: держи 20% сессий отложенными. Если ошибка на них заметно больше, чем на обучающих, параметры переобучены — сократи их число.
4. Пол: freejoint, реальные контакты. Подгоняй массу, центр масс и трение по записи стойки и медленной ходьбы, начальное состояние корпуса бери из IMU.
5. Перенеси результат в `conf/training/default.yaml`: `position_control_kp`, `dof_damping`, центры `*_multiplier_range` и `latency_distribution` — по найденным значениям, а ширину диапазонов сделай около ±15–20% от них вместо текущих широких. Armature и трение — в XML модели через `ModelManager.modify_model`.
6. Переобучи (GPU, `uv run python pupper_mjx_rl_training.py`), выгрузи json в `ros2_ws/src/neural_controller/launch/`, проверь на подставке, потом на полу с записью (протокол C).

## Если всё же учить на реальном роботе

Нужен ПК с GPU в той же сети: Pi 5 учить не потянет, на нём только инференс. Схема: робот шлёт наблюдения и получает действия по сети (задержка меньше 10 мс, иначе учи с этой задержкой в симуляции), ПК учит off-policy (SAC/DroQ/REDQ, высокое UTD). Стартовать лучше с политики из подогнанного симулятора (fine-tune), а не с нуля. Обязательно: e-stop по наклону больше 0.7 рад (как `terminal_body_angle`), ограничение по моменту и температуре, человек рядом. Ожидаемо 20–60 минут чистого времени на полу на одну конфигурацию. Запись `pupper_record.py` при этом сохраняет весь опыт для повторного офлайн-использования.
