Isugar239/fenec-monrepo/tools/pupper_screen/samples/pupper_loop.gif

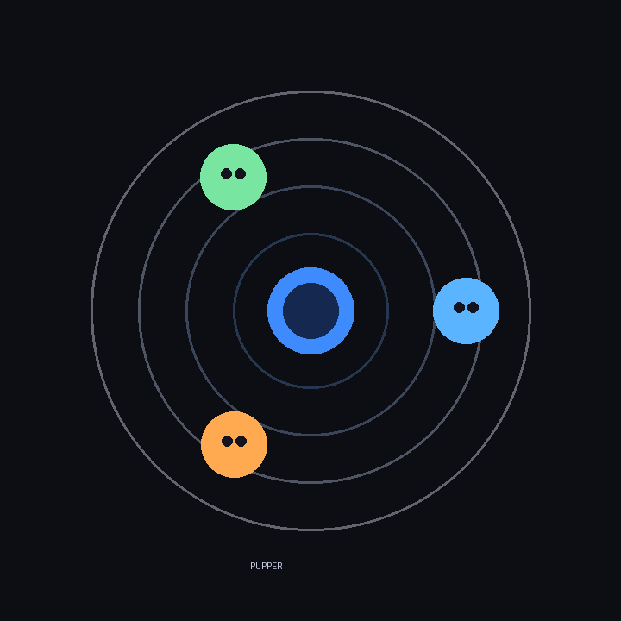
tools/pupper_screen/samples/pupper_loop.gif
