Isugar239/fenec-monrepo/ui4.png

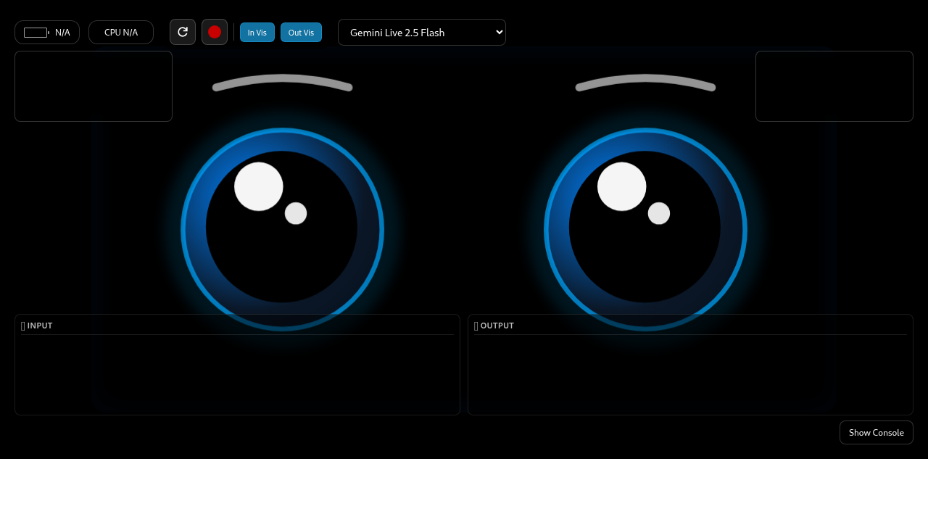
ui4.png
