Isugar239/fenec-monrepo/ailogs/2026-08-22_after_r2_solder_still_dead.md

# Лог: R2 (120 Ω) запаян — CAN2 всё ещё мёртв

Дата: **2026-08-22**, ~19:57 UTC+3  
Предыдущий: [2026-08-22_before_r2_solder_poweroff.md](2026-08-22_before_r2_solder_poweroff.md)

---

## Что сделали

Пользователь запаял **120 Ω (R2)** на мёртвый CAN2 контур.

---

## probe после пайки

```
[/dev/spidev0.0] CE0 board0 legs[0,1]: checksum_OK
    leg0: abad= 0.1223 hip= 0.2630 knee= 0.0280  ✅
    leg1: abad= 0.0000 hip= 0.0000 knee= 0.0000  ❌

Валидный ответ: 1/2 плат.
```

**Без изменений** — leg1 по-прежнему нули.

---

## wiggle после пайки

| Контур | abad | hip | knee |
|---|---|-----|---|
| CAN1 leg0 | 0.246 OK | 0.526 OK | 0.057 OK |
| CAN2 leg1 | 0.000 ❌ | 0.000 ❌ | 0.000 ❌ |

---

## Вывод

**R2 не был единственной причиной.** Терминация добавлена, но CAN2 по-прежнему не получает ответы от DAP.

Следующие подозреваемые (по E3.pdf):
1. Трансивер **DD4 (MAX3051)** — мёртв / плохая пайка
2. Дорожки CANH2/CANL2 от DD4 до разъёма
3. Pin'ы STM **PA11/PA12** (на E3) или **PB12/PB13** (на spine) — обрыв
4. Разъём на мёртвой ноге

---

## Следующие шаги (без осциллографа)

1. Мультиметр power off: H−L на **мёртвом** vs **живом** разъёме
2. Мультиметр power on: VCC pin3 DD4 = 3.3V, CANH/CANL ~1.5–2.5V
3. Визуальный осмотр пайки DD4 и разъёма
4. При наличии — замена/перепайка MAX3051 (DD4)
