Isugar239/fenec-monrepo/ailogs/2026-08-22_before_tx_resolder_2_poweroff.md

# Лог: перед 2-й перепайкой TX — probe OK, wiggle FAIL (ручное движение)

Дата: **2026-08-22**, ~21:02 UTC+3  
Предыдущий: [2026-08-22_can2_fixed_tx_resolder.md](2026-08-22_can2_fixed_tx_resolder.md)

---

## Важное уточнение от пользователя

Углы **leg1 в probe** после «улучшения» — от **ручного движения** ноги, не от wiggle-команд.

→ **RX работает** (STM читает ответы моторов)  
→ **TX не работает стабильно** (команды не доходят / нога не двигается от софта)

---

## Последний probe

```
leg0 CAN1: abad=0.107 hip=-0.283 knee=0.127  ✅
leg1 CAN2: abad=-0.018 hip=0.065 knee=-0.028  ✅ (после ручного движения)
```

## Последний wiggle CAN2

| Сустав | span | fb |
|---|---|-----|
| abad | 0.000 FAIL | застрял |
| hip | 0.000 FAIL | застрял |
| knee | 0.000 FAIL | застрял |

cmd меняется, fb не следует за cmd → **TX**.

---

## Что перепаять (power OFF)

**PB13 (STM TX)** → **pin 1 (TX)** у **DD4 (MAX3051)**

Советы:
- Флюс
- Прогреть **обе** площадки (STM + чип)
- Проверить прозвонкой после пайки: **писк** PB13 ↔ DD4 pin 1
- Заодно глянуть **PB12 ↔ DD4 pin 4 (RX)** — RX уже работает, но пайка не помешает

**R2 (120 Ω)** — уже стоит, не трогать.

---

## После включения

```bash
cd ~/pupperv3-monorepo/tools
sudo systemctl stop robot.service
sudo python3 spine_spi_test.py probe -v
```

**Не двигать ногу руками** — смотреть leg1 до wiggle.

Потом:
```bash
sudo python3 spine_spi_test.py wiggle-can2-all --seconds 3 --amplitude 0.12 --hz 0.4
```

**Критерий успеха:** fb **меняется** за cmd, span > 0.03, **нога двигается сама** (без рук).

---

## SSH

При power-off SSH отвалится — это нормально.
