Isugar239/fenec-monrepo/E3.pdf

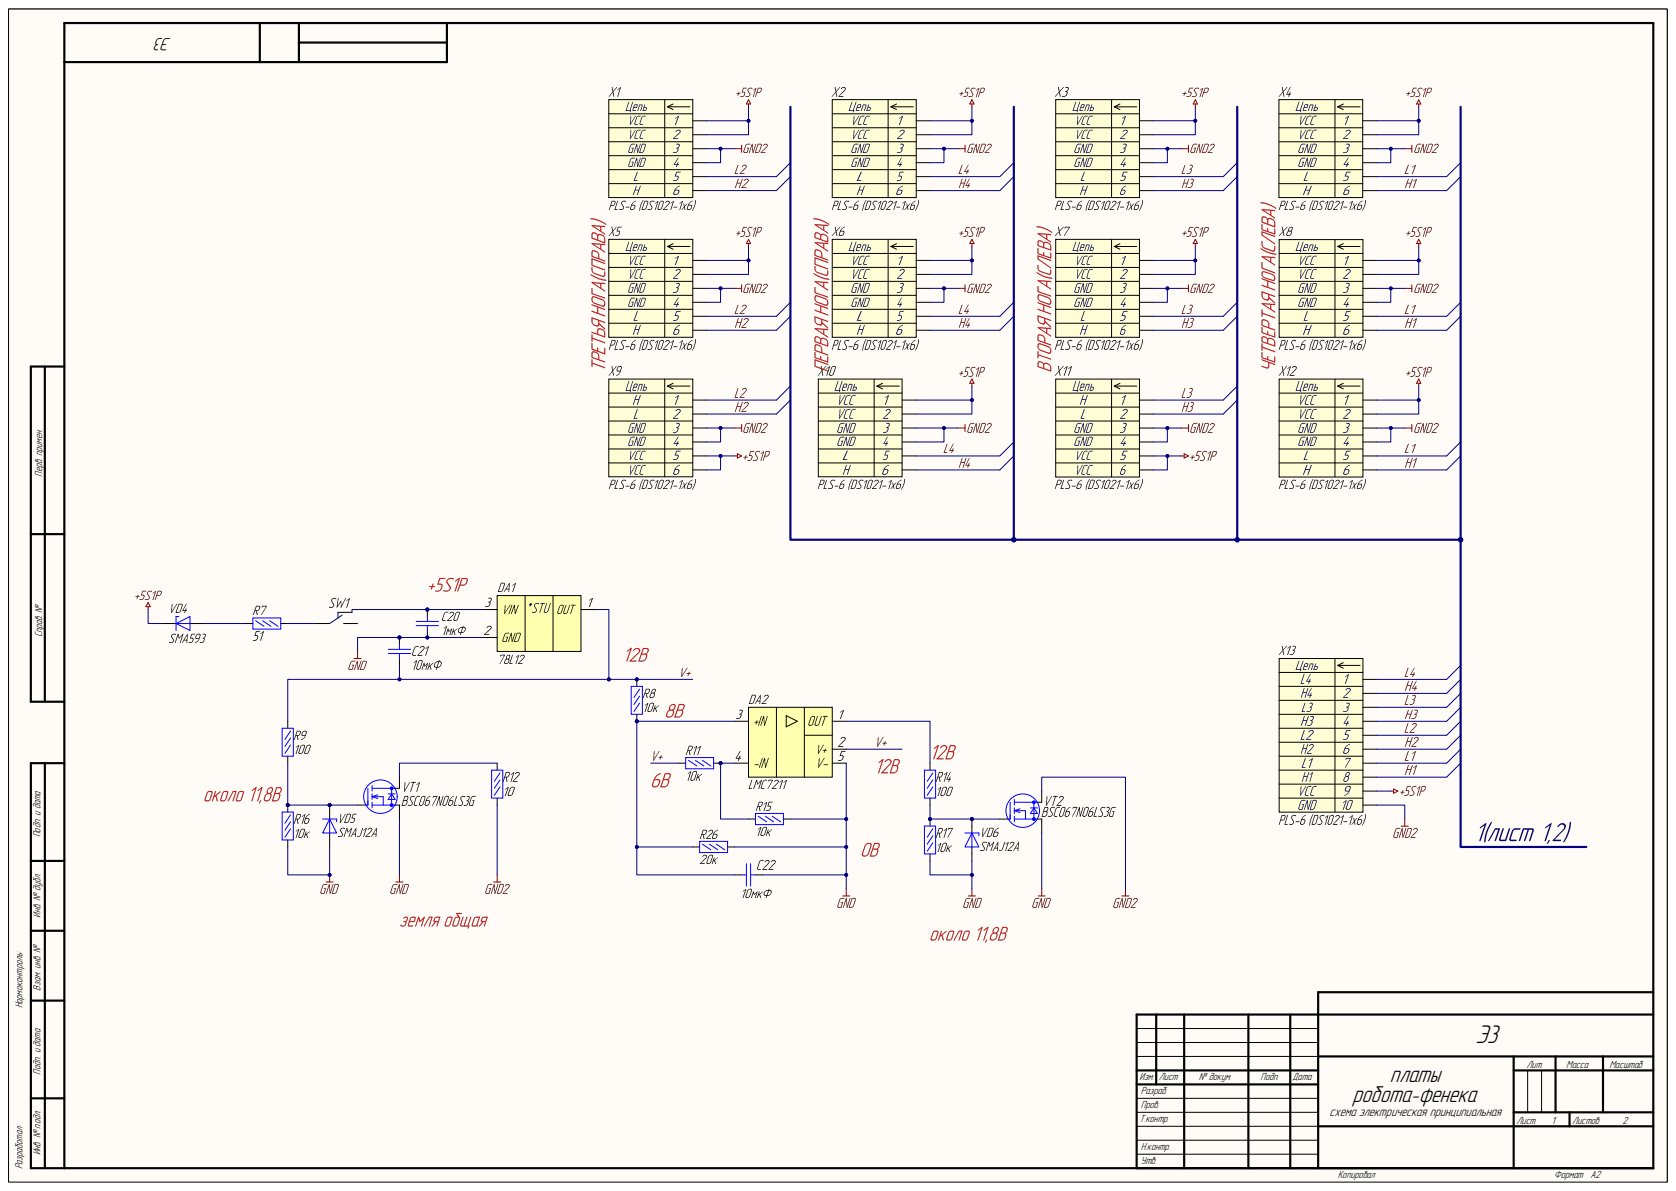
[picture p15: page 1]
Копировал; А2 Формат Инв. № подл. Инв. № дубл. Подп. и дата Взам. инв. № Подп. и дата Перв. примен. Справ. № Разработал: Нормоконтроль:

Изм. | Лист | № докум. | Подп. | Дата | | | Лит. | Масса | Масштаб 1

платы робота-фенека схема электрическая принципиальная

Разраб.
Пров.
Т.контр. | | | | | Лист | Листов 2

Н.контр.
Утв.

# Цепь

12345

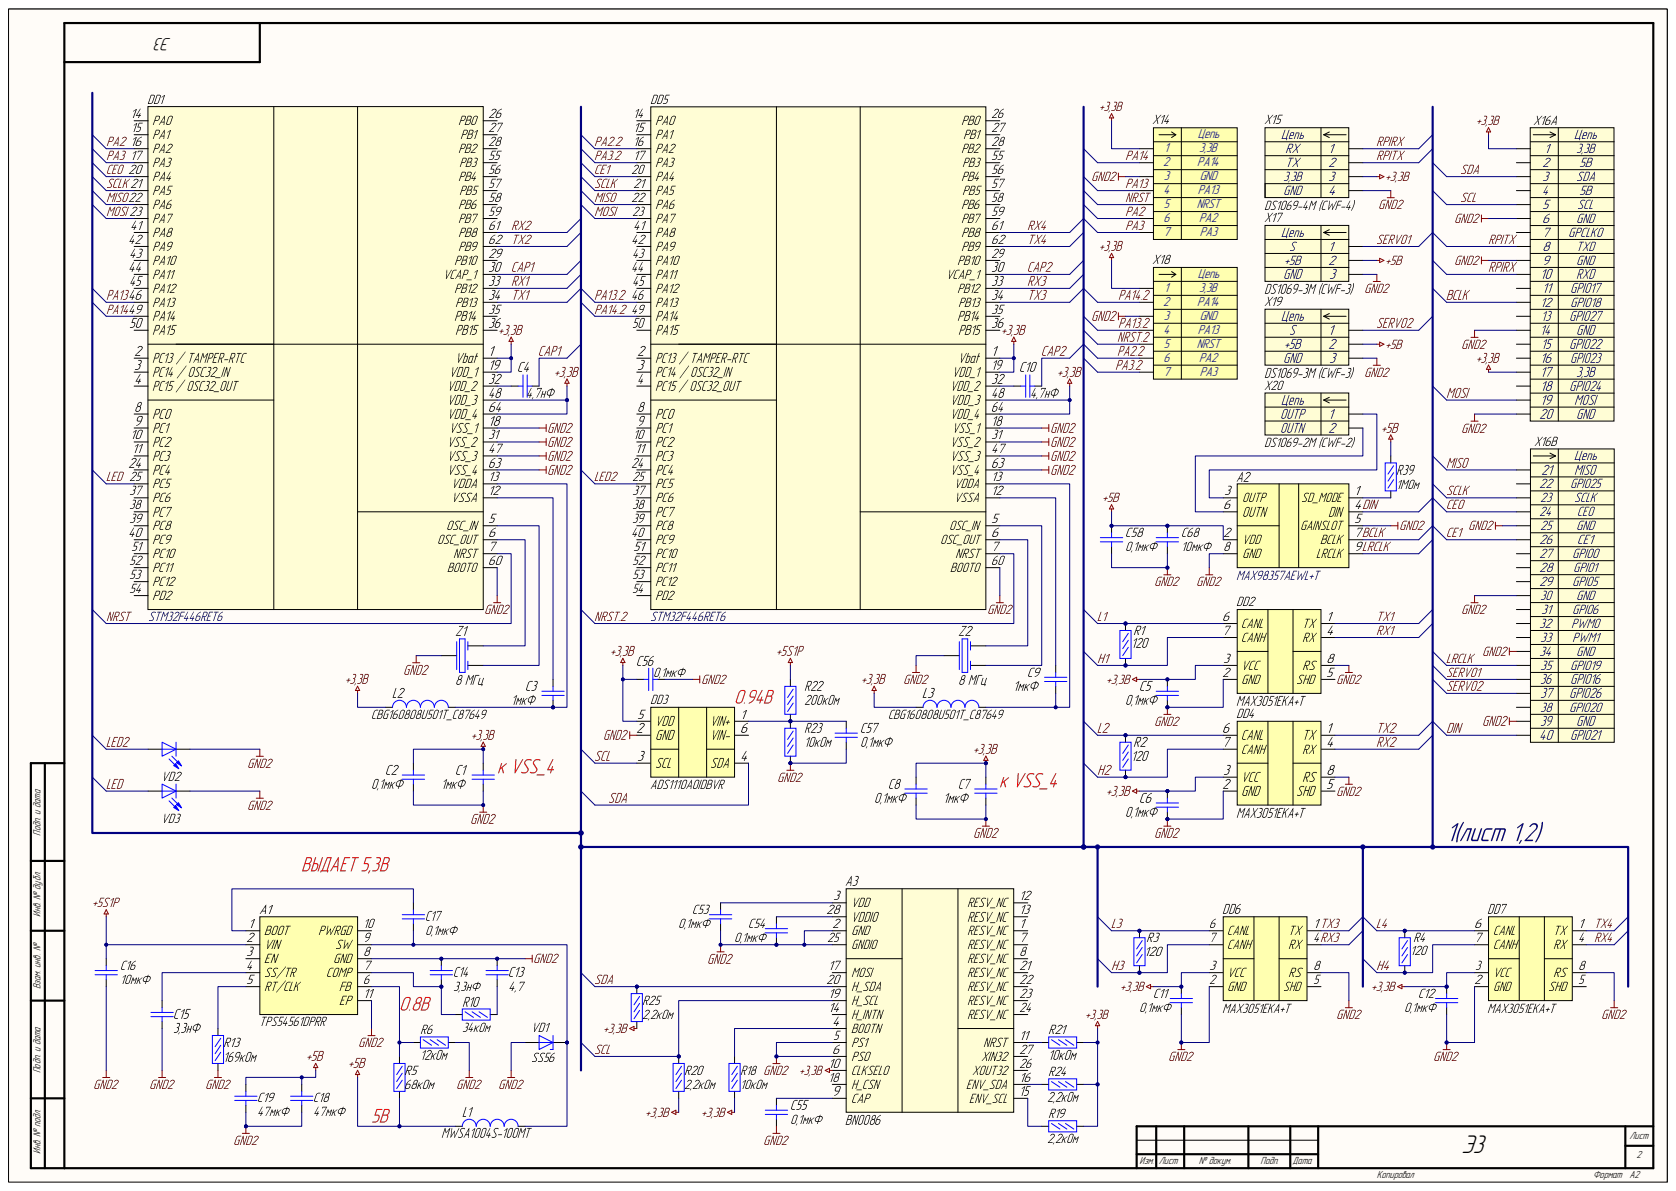
[picture p16: page 2]
Копировал; А2 Формат Инв. № подл. Инв. № дубл.; Э3 Подп. и дата Взам. инв. № Подп. и дата; 3,3B PA14 GND PA13 NRST 6 PA2 7 PA3; Цепь

Лист2

Изм. | № докум. | Подп. | Дата Лист
