Isugar239/fenec-monrepo/drive_spinev1/Core_unpacked/Core/Src/can.c

/**
  ******************************************************************************
  * @file    can.c
  * @brief   This file provides code for the configuration
  *          of the CAN instances.
  ******************************************************************************
  * @attention
  *
  * <h2><center>&copy; Copyright (c) 2022 STMicroelectronics.
  * All rights reserved.</center></h2>
  *
  * This software component is licensed by ST under BSD 3-Clause license,
  * the "License"; You may not use this file except in compliance with the
  * License. You may obtain a copy of the License at:
  *                        opensource.org/licenses/BSD-3-Clause
  *
  ******************************************************************************
  */

/* Includes ------------------------------------------------------------------*/
#include "can.h"

CAN_HandleTypeDef hcan1;
CAN_HandleTypeDef hcan2;

/* CAN1 init function */
void MX_CAN1_Init(void)
{

  hcan1.Instance = CAN1;
  hcan1.Init.Prescaler = 3;
  hcan1.Init.Mode = CAN_MODE_NORMAL;
  hcan1.Init.SyncJumpWidth = CAN_SJW_1TQ;
  hcan1.Init.TimeSeg1 = CAN_BS1_12TQ;
  hcan1.Init.TimeSeg2 = CAN_BS2_2TQ;
  hcan1.Init.TimeTriggeredMode = DISABLE;
  hcan1.Init.AutoBusOff = ENABLE;
  hcan1.Init.AutoWakeUp = DISABLE;
  hcan1.Init.AutoRetransmission = ENABLE;
  hcan1.Init.ReceiveFifoLocked = DISABLE;
  hcan1.Init.TransmitFifoPriority = DISABLE;
  if (HAL_CAN_Init(&hcan1) != HAL_OK)
  {
    Error_Handler();
  }
}
/* CAN2 init function */
void MX_CAN2_Init(void)
{

  hcan2.Instance = CAN2;
  hcan2.Init.Prescaler = 3;
  hcan2.Init.Mode = CAN_MODE_NORMAL;
  hcan2.Init.SyncJumpWidth = CAN_SJW_1TQ;
  hcan2.Init.TimeSeg1 = CAN_BS1_12TQ;
  hcan2.Init.TimeSeg2 = CAN_BS2_2TQ;
  hcan2.Init.TimeTriggeredMode = DISABLE;
  hcan2.Init.AutoBusOff = ENABLE;
  hcan2.Init.AutoWakeUp = DISABLE;
  hcan2.Init.AutoRetransmission = ENABLE;
  hcan2.Init.ReceiveFifoLocked = DISABLE;
  hcan2.Init.TransmitFifoPriority = DISABLE;
  if (HAL_CAN_Init(&hcan2) != HAL_OK)
  {
    Error_Handler();
  }
}

static uint32_t HAL_RCC_CAN1_CLK_ENABLED=0;

void HAL_CAN_MspInit(CAN_HandleTypeDef* canHandle)
{

  GPIO_InitTypeDef GPIO_InitStruct = {0};
  if(canHandle->Instance==CAN1)
  {
    /* CAN1 clock enable */
    HAL_RCC_CAN1_CLK_ENABLED++;
    if(HAL_RCC_CAN1_CLK_ENABLED==1){
      __HAL_RCC_CAN1_CLK_ENABLE();
    }

    __HAL_RCC_GPIOB_CLK_ENABLE();
    /**CAN1 GPIO Configuration
    PB8     ------> CAN1_RX
    PB9     ------> CAN1_TX
    */
    GPIO_InitStruct.Pin = GPIO_PIN_8|GPIO_PIN_9;
    GPIO_InitStruct.Mode = GPIO_MODE_AF_PP;
    GPIO_InitStruct.Pull = GPIO_PULLUP;
    GPIO_InitStruct.Speed = GPIO_SPEED_FREQ_VERY_HIGH;
    GPIO_InitStruct.Alternate = GPIO_AF9_CAN1;
    HAL_GPIO_Init(GPIOB, &GPIO_InitStruct);

  }
  else if(canHandle->Instance==CAN2)
  {
    /* CAN2 clock enable */
    __HAL_RCC_CAN2_CLK_ENABLE();
    HAL_RCC_CAN1_CLK_ENABLED++;
    if(HAL_RCC_CAN1_CLK_ENABLED==1){
      __HAL_RCC_CAN1_CLK_ENABLE();
    }

    __HAL_RCC_GPIOB_CLK_ENABLE();
    /**CAN2 GPIO Configuration
    PB12     ------> CAN2_RX
    PB13     ------> CAN2_TX
    */
    GPIO_InitStruct.Pin = GPIO_PIN_12|GPIO_PIN_13;
    GPIO_InitStruct.Mode = GPIO_MODE_AF_PP;
    GPIO_InitStruct.Pull = GPIO_PULLUP;
    GPIO_InitStruct.Speed = GPIO_SPEED_FREQ_VERY_HIGH;
    GPIO_InitStruct.Alternate = GPIO_AF9_CAN2;
    HAL_GPIO_Init(GPIOB, &GPIO_InitStruct);

  }
}

void HAL_CAN_MspDeInit(CAN_HandleTypeDef* canHandle)
{

  if(canHandle->Instance==CAN1)
  {
    /* Peripheral clock disable */
    HAL_RCC_CAN1_CLK_ENABLED--;
    if(HAL_RCC_CAN1_CLK_ENABLED==0){
      __HAL_RCC_CAN1_CLK_DISABLE();
    }

    /**CAN1 GPIO Configuration
    PB8     ------> CAN1_RX
    PB9     ------> CAN1_TX
    */
    HAL_GPIO_DeInit(GPIOB, GPIO_PIN_8|GPIO_PIN_9);

  }
  else if(canHandle->Instance==CAN2)
  {
    /* Peripheral clock disable */
    __HAL_RCC_CAN2_CLK_DISABLE();
    HAL_RCC_CAN1_CLK_ENABLED--;
    if(HAL_RCC_CAN1_CLK_ENABLED==0){
      __HAL_RCC_CAN1_CLK_DISABLE();
    }

    /**CAN2 GPIO Configuration
    PB12     ------> CAN2_RX
    PB13     ------> CAN2_TX
    */
    HAL_GPIO_DeInit(GPIOB, GPIO_PIN_12|GPIO_PIN_13);

  }
}

/* USER CODE BEGIN 1 */

void can_rx_init(CANRxMessage *msg, CAN_HandleTypeDef *CAN_H){
	msg->filter.FilterFIFOAssignment=CAN_FILTER_FIFO0; 	// set fifo assignment
	msg->filter.FilterIdHigh=CAN_ID<<5; 				// CAN ID
	msg->filter.FilterIdLow=0x0;
	msg->filter.FilterMaskIdHigh=0xFFE0;
	msg->filter.FilterMaskIdLow=0004;
	msg->filter.FilterMode = CAN_FILTERMODE_IDMASK;
	msg->filter.FilterScale=CAN_FILTERSCALE_32BIT;
	msg->filter.FilterActivation=ENABLE;
	HAL_CAN_ConfigFilter(CAN_H, &msg->filter);
}

void can_tx_init(CANTxMessage *msg, int ID){
	msg->tx_header.DLC = 8; 			// message size of 8 byte
	msg->tx_header.IDE=CAN_ID_STD; 		// set identifier to standard
	msg->tx_header.RTR=CAN_RTR_DATA; 	// set data type to remote transmission request?
	msg->tx_header.StdId = ID;  // recipient CAN ID
	msg->id = ID;
}

/// CAN Command Packet Structure ///
/// 16 bit position command, between -4*pi and 4*pi
/// 12 bit velocity command, between -30 and + 30 rad/s
/// 12 bit kp, between 0 and 500 N-m/rad
/// 12 bit kd, between 0 and 100 N-m*s/rad
/// 12 bit feed forward torque, between -18 and 18 N-m
/// CAN Packet is 8 8-bit words
/// Formatted as follows.  For each quantity, bit 0 is LSB
/// 0: [position[15-8]]
/// 1: [position[7-0]]
/// 2: [velocity[11-4]]
/// 3: [velocity[3-0], kp[11-8]]
/// 4: [kp[7-0]]
/// 5: [kd[11-4]]
/// 6: [kd[3-0], torque[11-8]]
/// 7: [torque[7-0]]

void pack_cmd(CANTxMessage *msg, joint_control joint)
{

    /// limit data to be within bounds ///
    float p_des = fminf(fmaxf(P_MIN, joint.p_des), P_MAX);
    float v_des = fminf(fmaxf(V_MIN, joint.v_des), V_MAX);
    float kp = fminf(fmaxf(KP_MIN, joint.kp), KP_MAX);
    float kd = fminf(fmaxf(KD_MIN, joint.kd), KD_MAX);
    float t_ff = fminf(fmaxf(T_MIN, joint.t_ff), T_MAX);
    /// convert floats to unsigned ints ///
    int p_int = float_to_uint(p_des, P_MIN, P_MAX, 16);
    int v_int = float_to_uint(v_des, V_MIN, V_MAX, 12);
    int kp_int = float_to_uint(kp, KP_MIN, KP_MAX, 12);
    int kd_int = float_to_uint(kd, KD_MIN, KD_MAX, 12);
    int t_int = float_to_uint(t_ff, T_MIN, T_MAX, 12);
    /// pack ints into the can buffer ///
    msg->data[0] = p_int >> 8;
    msg->data[1] = p_int & 0xFF;
    msg->data[2] = v_int >> 4;
    msg->data[3] = ((v_int & 0xF) << 4) | (kp_int >> 8);
    msg->data[4] = kp_int & 0xFF;
    msg->data[5] = kd_int >> 4;
    msg->data[6] = ((kd_int & 0xF) << 4) | (t_int >> 8);
    msg->data[7] = t_int & 0xff;

}

/// CAN Reply Packet Structure ///
/// 16 bit position, between -4*pi and 4*pi
/// 12 bit velocity, between -30 and + 30 rad/s
/// 12 bit current, between -40 and 40;
/// CAN Packet is 5 8-bit words
/// Formatted as follows.  For each quantity, bit 0 is LSB
/// 0: [position[15-8]]
/// 1: [position[7-0]]
/// 2: [velocity[11-4]]
/// 3: [velocity[3-0], current[11-8]]
/// 4: [current[7-0]]

void unpack_reply(CANRxMessage msg, leg_state *leg)
{
    /// unpack ints from can buffer ///
    uint16_t id = msg.data[0];
    uint16_t p_int = (msg.data[1]<<8)|msg.data[2];
    uint16_t v_int = (msg.data[3]<<4)|(msg.data[4]>>4);
    uint16_t i_int = ((msg.data[4]&0xF)<<8)|msg.data[5];
    /// convert uints to floats ///
    float p = uint_to_float(p_int, P_MIN, P_MAX, 16);
    float v = uint_to_float(v_int, V_MIN, V_MAX, 12);
    float t = uint_to_float(i_int, -T_MAX, T_MAX, 12);
//    printf("%d %.3f %.3f %.3f\n\r", id, p, v, t);
    if (id == 1)
    {
        leg->a.p = p;
        leg->a.v = v;
        leg->a.t = t;
    }
    else if (id == 2)
    {
        leg->h.p = p;
        leg->h.v = v;
        leg->h.t = t;
    }
    else if (id == 3)
    {
        leg->k.p = p;
        leg->k.v = v;
        leg->k.t = t;
    }
}
void EnterMotorMode(CANTxMessage *msg)
{
    msg->data[0] = 0xFF;
    msg->data[1] = 0xFF;
    msg->data[2] = 0xFF;
    msg->data[3] = 0xFF;
    msg->data[4] = 0xFF;
    msg->data[5] = 0xFF;
    msg->data[6] = 0xFF;
    msg->data[7] = 0xFC;
}

void ExitMotorMode(CANTxMessage *msg)
{
    msg->data[0] = 0xFF;
    msg->data[1] = 0xFF;
    msg->data[2] = 0xFF;
    msg->data[3] = 0xFF;
    msg->data[4] = 0xFF;
    msg->data[5] = 0xFF;
    msg->data[6] = 0xFF;
    msg->data[7] = 0xFD;
}

void Zero(CANTxMessage *msg)
{
    msg->data[0] = 0xFF;
    msg->data[1] = 0xFF;
    msg->data[2] = 0xFF;
    msg->data[3] = 0xFF;
    msg->data[4] = 0xFF;
    msg->data[5] = 0xFF;
    msg->data[6] = 0xFF;
    msg->data[7] = 0xFE;
}
/* USER CODE END 1 */

/************************ (C) COPYRIGHT STMicroelectronics *****END OF FILE****/
