Isugar239/fenec-monrepo/drive_spinev1/Core_unpacked/Core/Inc/can.h

/**
  ******************************************************************************
  * @file    can.h
  * @brief   This file contains all the function prototypes for
  *          the can.c file
  ******************************************************************************
  * @attention
  *
  * <h2><center>&copy; Copyright (c) 2022 STMicroelectronics.
  * All rights reserved.</center></h2>
  *
  * This software component is licensed by ST under BSD 3-Clause license,
  * the "License"; You may not use this file except in compliance with the
  * License. You may obtain a copy of the License at:
  *                        opensource.org/licenses/BSD-3-Clause
  *
  ******************************************************************************
  */
/* Define to prevent recursive inclusion -------------------------------------*/
#ifndef __CAN_H__
#define __CAN_H__

#ifdef __cplusplus
extern "C" {
#endif

/* Includes ------------------------------------------------------------------*/
#include "main.h"

/* USER CODE BEGIN Includes */
#include "constants.h"
#include "leg_message.h"
#include "math_ops.h"
#include "usart.h"
/* USER CODE END Includes */

extern CAN_HandleTypeDef hcan1;
extern CAN_HandleTypeDef hcan2;

void MX_CAN1_Init(void);
void MX_CAN2_Init(void);

/* USER CODE BEGIN Prototypes */
typedef struct{
	uint8_t id;
	uint8_t data[8];
	CAN_RxHeaderTypeDef rx_header;
	CAN_FilterTypeDef filter;
}CANRxMessage ;

typedef struct{
	uint8_t id;
	uint8_t data[8];
	CAN_TxHeaderTypeDef tx_header;
}CANTxMessage ;

void can_rx_init(CANRxMessage *msg, CAN_HandleTypeDef *CAN_H);
void can_tx_init(CANTxMessage *msg, int ID);
void pack_cmd(CANTxMessage *msg, joint_control joint);
void unpack_reply(CANRxMessage msg, leg_state *leg);
void EnterMotorMode(CANTxMessage *msg);
void ExitMotorMode(CANTxMessage *msg);
void Zero(CANTxMessage *msg);

/* USER CODE END Prototypes */

#ifdef __cplusplus
}
#endif

#endif /* __CAN_H__ */

/************************ (C) COPYRIGHT STMicroelectronics *****END OF FILE****/
