Isugar239/fenec-monrepo/tools/pupper_dashboard/screen_ctl.py

#!/usr/bin/env python3
"""Управление HDMI-экраном робота: медиатека и живые виды позы.

Медиа лежит в tools/pupper_screen/media (общая библиотека).
"""

from __future__ import annotations

import cgi
import json
import mimetypes
import os
import re
import signal
import subprocess
import time
import uuid
from http.server import BaseHTTPRequestHandler
from pathlib import Path
from urllib.parse import unquote, urlparse

PORT = 8091
DASH_ROOT = Path(__file__).resolve().parent
SCREEN_ROOT = DASH_ROOT.parent / "pupper_screen"
MEDIA = SCREEN_ROOT / "media"
LIBRARY = MEDIA / "library.json"
VIEW_HTML = DASH_ROOT / "view.html"
CHROMIUM_PROFILE = Path("/tmp/fenek-screen-chromium")
VIEW_URL = f"http://127.0.0.1:{PORT}/view"
CDP_PORT = 9222
CDP_BASE = f"http://127.0.0.1:{CDP_PORT}"

IMAGE_EXT = {".jpg", ".jpeg", ".png", ".gif", ".webp", ".bmp"}
VIDEO_EXT = {".mp4", ".webm", ".mov", ".mkv", ".m4v", ".ogv"}
YT_RE = re.compile(
    r"(?:youtube\.com/watch\?v=|youtu\.be/|youtube\.com/embed/|"
    r"youtube\.com/shorts/|youtube\.com/live/)([A-Za-z0-9_-]{11})"
)

LIVE_ITEMS = {
    "tri": {
        "id": "live:tri",
        "type": "live",
        "mode": "tri",
        "name": "Положение · треугольник",
    },
    "motors": {
        "id": "live:motors",
        "type": "live",
        "mode": "motors",
        "name": "Все моторы",
    },
}

_chromium_proc: subprocess.Popen | None = None


def _load_library() -> dict:
    if not LIBRARY.exists():
        return {"items": [], "current": None}
    return json.loads(LIBRARY.read_text(encoding="utf-8"))


def _save_library(data: dict) -> None:
    MEDIA.mkdir(parents=True, exist_ok=True)
    LIBRARY.write_text(json.dumps(data, ensure_ascii=False, indent=2), encoding="utf-8")


def ensure_library() -> None:
    MEDIA.mkdir(parents=True, exist_ok=True)
    if not LIBRARY.exists():
        _save_library({"items": [], "current": None})


def _youtube_id(url: str) -> str | None:
    m = YT_RE.search(url.strip())
    return m.group(1) if m else None


def _safe_name(name: str) -> str:
    base = os.path.basename(name).replace(" ", "_")
    base = re.sub(r"[^A-Za-z0-9._\-а-яА-ЯёЁ]", "", base)
    return base or f"file_{uuid.uuid4().hex[:8]}"


def _find_item(data: dict, item_id: str) -> dict | None:
    if item_id in ("live:tri", "live:motors"):
        mode = item_id.split(":", 1)[1]
        return dict(LIVE_ITEMS[mode])
    for item in data["items"]:
        if item["id"] == item_id:
            return item
    return None


def _chromium_env() -> dict[str, str]:
    env = os.environ.copy()
    env["DISPLAY"] = ":0"
    env["XAUTHORITY"] = str(Path.home() / ".Xauthority")
    runtime = f"/run/user/{os.getuid()}"
    env["XDG_RUNTIME_DIR"] = runtime
    wayland = Path(runtime) / "wayland-0"
    if wayland.exists():
        env["WAYLAND_DISPLAY"] = "wayland-0"
    else:
        env.pop("WAYLAND_DISPLAY", None)
    return env


def _chromium_pids() -> list[str]:
    result = subprocess.run(
        ["pgrep", "-f", f"user-data-dir={CHROMIUM_PROFILE}"],
        capture_output=True,
        text=True,
    )
    if result.returncode != 0:
        return []
    return [p for p in result.stdout.split() if p]


def chromium_running() -> bool:
    global _chromium_proc
    if _chromium_proc is not None and _chromium_proc.poll() is None:
        return True
    return bool(_chromium_pids())


def _youtube_watch_url(youtube_id: str) -> str:
    return f"https://www.youtube.com/watch?v={youtube_id}"


def _display_url(item: dict | None) -> str:
    # Живые виды и медиа остаются на /view (страница сама переключается по /api/current).
    # YouTube — отдельный URL: iframe с localhost блокируется.
    if item and item.get("type") == "youtube" and item.get("youtube_id"):
        return _youtube_watch_url(item["youtube_id"])
    return VIEW_URL


def _cdp_json(path: str):
    import urllib.request

    with urllib.request.urlopen(f"{CDP_BASE}{path}", timeout=2.0) as resp:
        return json.loads(resp.read().decode("utf-8"))


def _cdp_page() -> dict | None:
    try:
        tabs = _cdp_json("/json/list")
    except Exception:
        return None
    for tab in tabs:
        if tab.get("type") == "page" and tab.get("webSocketDebuggerUrl"):
            return tab
    return None


def _ws_cdp_navigate(ws_url: str, url: str) -> None:
    """Один CDP Page.navigate без сторонних пакетов."""
    import base64
    import hashlib
    import select
    import socket
    import struct
    from urllib.parse import urlparse

    u = urlparse(ws_url)
    host, port = u.hostname or "127.0.0.1", u.port or 80
    path = u.path + (("?" + u.query) if u.query else "")
    key = base64.b64encode(os.urandom(16)).decode("ascii")
    req = (
        f"GET {path} HTTP/1.1\r\n"
        f"Host: {host}:{port}\r\n"
        "Upgrade: websocket\r\n"
        "Connection: Upgrade\r\n"
        f"Sec-WebSocket-Key: {key}\r\n"
        "Sec-WebSocket-Version: 13\r\n"
        "\r\n"
    ).encode()
    sock = socket.create_connection((host, port), timeout=3.0)
    sock.sendall(req)
    buf = b""
    while b"\r\n\r\n" not in buf:
        chunk = sock.recv(4096)
        if not chunk:
            sock.close()
            raise RuntimeError("CDP websocket: нет ответа handshake")
        buf += chunk
    head, _ = buf.split(b"\r\n\r\n", 1)
    if b"101" not in head.split(b"\r\n", 1)[0]:
        sock.close()
        raise RuntimeError(f"CDP websocket handshake failed: {head[:120]!r}")
    expected = base64.b64encode(
        hashlib.sha1((key + "258EAFA5-E914-47DA-95CA-C5AB0DC85B11").encode()).digest()
    ).decode()
    if expected.encode() not in head:
        sock.close()
        raise RuntimeError("CDP websocket: плохой accept")

    payload = json.dumps(
        {"id": 1, "method": "Page.navigate", "params": {"url": url}}
    ).encode("utf-8")
    mask = os.urandom(4)
    header = bytearray([0x81])
    n = len(payload)
    if n < 126:
        header.append(0x80 | n)
    elif n < 65536:
        header.append(0x80 | 126)
        header.extend(struct.pack("!H", n))
    else:
        header.append(0x80 | 127)
        header.extend(struct.pack("!Q", n))
    header.extend(mask)
    masked = bytes(b ^ mask[i % 4] for i, b in enumerate(payload))
    sock.sendall(header + masked)
    # Коротко ждём ack, но не блокируем надолго.
    ready, _, _ = select.select([sock], [], [], 1.0)
    if ready:
        sock.recv(65536)
    sock.close()


def navigate_chromium(url: str) -> bool:
    """Перейти на URL в уже открытом kiosk. False — CDP недоступен."""
    page = _cdp_page()
    if page is None:
        return False
    current = page.get("url") or ""
    if current.rstrip("/") == url.rstrip("/"):
        return True
    # Уже на /view, а нужен снова /view — контент подтянется через poll.
    if current.startswith(VIEW_URL) and url.startswith(VIEW_URL):
        return True
    _ws_cdp_navigate(page["webSocketDebuggerUrl"], url)
    return True


def start_chromium(url: str = VIEW_URL, *, force: bool = False) -> None:
    global _chromium_proc
    if chromium_running():
        if not force:
            navigate_chromium(url)
            return
        stop_chromium()
        time.sleep(0.4)
    CHROMIUM_PROFILE.mkdir(parents=True, exist_ok=True)
    browser = "chromium-browser" if Path("/usr/bin/chromium-browser").exists() else "chromium"
    cmd = [
        browser,
        f"--user-data-dir={CHROMIUM_PROFILE}",
        f"--remote-debugging-port={CDP_PORT}",
        "--remote-allow-origins=*",
        "--kiosk",
        "--start-fullscreen",
        "--noerrdialogs",
        "--disable-infobars",
        "--disable-session-crashed-bubble",
        "--check-for-update-interval=31536000",
        "--autoplay-policy=no-user-gesture-required",
        url,
    ]
    log_path = Path("/tmp/fenek-screen-chromium.log")
    log_f = log_path.open("w", encoding="utf-8")
    _chromium_proc = subprocess.Popen(
        cmd,
        env=_chromium_env(),
        stdout=log_f,
        stderr=subprocess.STDOUT,
        start_new_session=True,
    )
    deadline = time.monotonic() + 8.0
    while time.monotonic() < deadline:
        if _chromium_proc.poll() is not None:
            log_f.close()
            log_tail = log_path.read_text(encoding="utf-8")[-800:]
            raise RuntimeError(
                f"Chromium сразу завершился (код {_chromium_proc.returncode}). "
                f"Лог: {log_path}\n{log_tail}"
            )
        if _cdp_page() is not None:
            return
        time.sleep(0.2)
    # Браузер жив, даже если CDP ещё не ответил.


def stop_chromium() -> None:
    global _chromium_proc
    if _chromium_proc is not None and _chromium_proc.poll() is None:
        os.killpg(os.getpgid(_chromium_proc.pid), signal.SIGTERM)
        _chromium_proc.wait(timeout=5)
        _chromium_proc = None
    for pid in _chromium_pids():
        os.kill(int(pid), signal.SIGTERM)
    time.sleep(0.3)


def apply_display(item: dict | None) -> None:
    """Показать item без перезапуска браузера (если он уже открыт)."""
    url = _display_url(item)
    if chromium_running():
        if not navigate_chromium(url):
            # Старый профиль без CDP — один раз перезапустим с debug-портом.
            start_chromium(url, force=True)
        return
    start_chromium(url, force=False)


def json_response(handler: BaseHTTPRequestHandler, code: int, payload: dict) -> None:
    body = json.dumps(payload, ensure_ascii=False).encode("utf-8")
    handler.send_response(code)
    handler.send_header("Content-Type", "application/json; charset=utf-8")
    handler.send_header("Content-Length", str(len(body)))
    handler.send_header("Cache-Control", "no-store")
    handler.end_headers()
    handler.wfile.write(body)


def send_file(handler: BaseHTTPRequestHandler, path: Path, content_type: str) -> None:
    raw = path.read_bytes()
    handler.send_response(200)
    handler.send_header("Content-Type", content_type)
    handler.send_header("Content-Length", str(len(raw)))
    handler.send_header("Cache-Control", "no-store")
    handler.end_headers()
    handler.wfile.write(raw)


def _read_json(handler: BaseHTTPRequestHandler) -> dict:
    length = int(handler.headers.get("Content-Length", "0"))
    raw = handler.rfile.read(length) if length else b"{}"
    return json.loads(raw.decode("utf-8"))


def handle_get(handler: BaseHTTPRequestHandler) -> bool:
    """Обработать GET экрана. True — ответ уже отправлен."""
    path = urlparse(handler.path).path
    if path == "/view":
        send_file(handler, VIEW_HTML, "text/html; charset=utf-8")
        return True
    if path == "/api/media":
        data = _load_library()
        json_response(handler, 200, data)
        return True
    if path == "/api/current":
        data = _load_library()
        item = _find_item(data, data["current"]) if data.get("current") else None
        json_response(
            handler,
            200,
            {
                "current": data.get("current"),
                "item": item,
                "chromium": chromium_running(),
            },
        )
        return True
    if path == "/api/screen_status":
        json_response(handler, 200, {"chromium": chromium_running(), "port": PORT})
        return True
    if path.startswith("/media/"):
        name = unquote(path[len("/media/") :])
        if "/" in name or ".." in name:
            json_response(handler, 400, {"error": "неверное имя файла"})
            return True
        fpath = MEDIA / name
        if not fpath.is_file():
            json_response(handler, 404, {"error": "файл не найден"})
            return True
        ctype = mimetypes.guess_type(str(fpath))[0] or "application/octet-stream"
        send_file(handler, fpath, ctype)
        return True
    return False


def handle_post(handler: BaseHTTPRequestHandler) -> bool:
    """Обработать POST экрана. True — ответ уже отправлен."""
    path = urlparse(handler.path).path
    if path == "/api/upload":
        _upload(handler)
        return True
    if path == "/api/youtube":
        body = _read_json(handler)
        url = (body.get("url") or "").strip()
        vid = _youtube_id(url)
        if not vid:
            json_response(handler, 400, {"error": "не распознал YouTube-ссылку"})
            return True
        data = _load_library()
        item = {
            "id": uuid.uuid4().hex,
            "type": "youtube",
            "name": body.get("name") or f"YouTube {vid}",
            "youtube_id": vid,
            "url": url,
            "added": time.time(),
        }
        data["items"].insert(0, item)
        _save_library(data)
        json_response(handler, 200, {"item": item})
        return True
    if path == "/api/show":
        body = _read_json(handler)
        item_id = body.get("id")
        data = _load_library()
        item = _find_item(data, item_id) if item_id else None
        if item is None:
            json_response(handler, 404, {"error": "элемент не найден"})
            return True
        data["current"] = item_id
        _save_library(data)
        apply_display(item)
        json_response(handler, 200, {"ok": True, "item": item, "chromium": True})
        return True
    if path == "/api/show_live":
        body = _read_json(handler)
        mode = str(body.get("mode", ""))
        if mode not in LIVE_ITEMS:
            json_response(handler, 400, {"error": "режим: tri или motors"})
            return True
        item = dict(LIVE_ITEMS[mode])
        data = _load_library()
        data["current"] = item["id"]
        _save_library(data)
        apply_display(item)
        json_response(handler, 200, {"ok": True, "item": item, "chromium": True})
        return True
    if path == "/api/screen_stop":
        data = _load_library()
        data["current"] = None
        _save_library(data)
        stop_chromium()
        json_response(handler, 200, {"ok": True})
        return True
    if path == "/api/open_screen":
        data = _load_library()
        item = _find_item(data, data["current"]) if data.get("current") else None
        apply_display(item)
        json_response(handler, 200, {"ok": True, "chromium": True})
        return True
    return False


def handle_delete(handler: BaseHTTPRequestHandler) -> bool:
    path = urlparse(handler.path).path
    if not path.startswith("/api/media/"):
        return False
    item_id = path[len("/api/media/") :]
    data = _load_library()
    item = None
    for i in data["items"]:
        if i["id"] == item_id:
            item = i
            break
    if item is None:
        json_response(handler, 404, {"error": "элемент не найден"})
        return True
    if item["type"] in ("image", "video") and item.get("file"):
        fpath = MEDIA / item["file"]
        if fpath.is_file():
            fpath.unlink()
    data["items"] = [i for i in data["items"] if i["id"] != item_id]
    if data.get("current") == item_id:
        data["current"] = None
    _save_library(data)
    json_response(handler, 200, {"ok": True})
    return True


def _upload(handler: BaseHTTPRequestHandler) -> None:
    form = cgi.FieldStorage(
        fp=handler.rfile,
        headers=handler.headers,
        environ={
            "REQUEST_METHOD": "POST",
            "CONTENT_TYPE": handler.headers.get("Content-Type", ""),
            "CONTENT_LENGTH": handler.headers.get("Content-Length", "0"),
        },
    )
    if "file" not in form:
        json_response(handler, 400, {"error": "нет поля file"})
        return
    field = form["file"]
    if isinstance(field, list):
        field = field[0]
    if not getattr(field, "filename", None):
        json_response(handler, 400, {"error": "пустой файл"})
        return
    original = field.filename
    ext = Path(original).suffix.lower()
    if ext in IMAGE_EXT:
        kind = "image"
    elif ext in VIDEO_EXT:
        kind = "video"
    else:
        json_response(
            handler,
            400,
            {
                "error": f"формат {ext or '(без расширения)'} не поддержан",
                "hint": "фото: jpg/png/gif/webp; видео: mp4/webm/mov/mkv",
            },
        )
        return
    MEDIA.mkdir(parents=True, exist_ok=True)
    safe = _safe_name(original)
    stored = f"{uuid.uuid4().hex[:10]}_{safe}"
    dest = MEDIA / stored
    data_bytes = field.file.read()
    if not data_bytes:
        json_response(handler, 400, {"error": "файл пустой"})
        return
    dest.write_bytes(data_bytes)
    data = _load_library()
    item = {
        "id": uuid.uuid4().hex,
        "type": kind,
        "name": original,
        "file": stored,
        "added": time.time(),
    }
    data["items"].insert(0, item)
    _save_library(data)
    json_response(handler, 200, {"item": item})
