Isugar239/fenec-monrepo/(commit log)

2026-06-23 Save workspace state before IMU estop bypass for motor bring-up.
2026-06-23 Temporarily disable IMU fall-detection estop for motor bring-up.
    BNO055 I2C reads are unreliable; bad orientation was triggering
    Emergency stop ~1s after activate and leaving motors limp.
2026-07-20 Bring-up одной лапы (CE0/CAN1): SPI timeout firmware и тесты.
    Пропатченный SPIneV1 без вечного HAL_MAX_DELAY, board0-only/wiggle-can1-all в tools, плюс нормальный .gitignore без __pycache__.
2026-08-31 spine_spi_test: identity-маппинг осей как в robot.service + motor-probe диагностика
    - убраны искусственные SIDE_SIGN=-1: команды/состояния теперь 1-в-1 как
    control_board_hardware_interface (иначе abad правой ноги получала неверное направление)
    - согласовано преобразование qd_des для knee
    - новая команда motor-probe: ±амплитуда от текущей позиции с вердиктом
    (нет момента / момент в одну сторону / механика), для диагностики CAN2 abad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
2026-09-15 fixing led
2026-09-23 Суставы едут, стойка кривая: включаем БНО.
    Хоуминг с задних ног, карта моторов, пульт с походкой. Pitch −90° и use_imu=true, чтобы чип читался после рестарта.
2026-10-02 Снимок рабочей станции: BNO/драйвер, пульт, экран и SPI LED по кадру.
    Фиксируем .gitmodules и текущий bring-up (motor map, neural launch, tools),
    чтобы можно было спокойно разбирать код локально. Загрузки media экрана не в коммите.
2026-10-02 WIP: питание BNO через GPIO17/BC557, без подпитки по I2C и без stale quat.
    Эксперимент power-cycle (active-low + SDA/SCL=0 на off), чекбокс /imu_power,
    фильтр свежести ориентации. Чип при 0↔3.3 всё равно молчит — оставляем снимок.
